antoniolosada/SLOT/docs/Componentes/atmega328-arduino-pinout.jpg

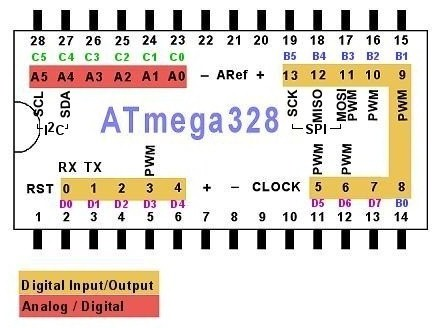
docs/Componentes/atmega328-arduino-pinout.jpg
