antoniolosada/SLOT/docs/NanoAnalogPinChanges.resized.jpg

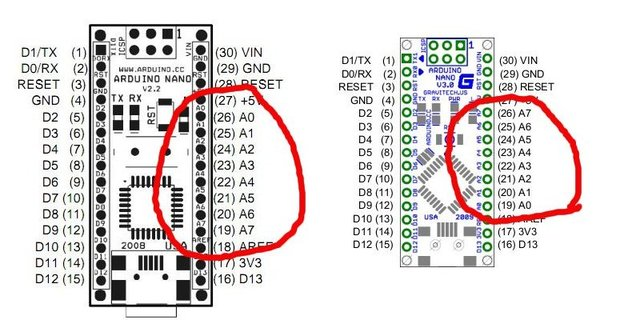
docs/NanoAnalogPinChanges.resized.jpg
