antoniolosada/SLOT/ArduinoProgramacion/usbasp-windriver.2011-05-28/Readme.txt

With WinAVR version 20100110 or older, please use libusb_0.1.12.1.
