antoniolosada/SLOT/docs/Fotos/IMG_2041.JPG

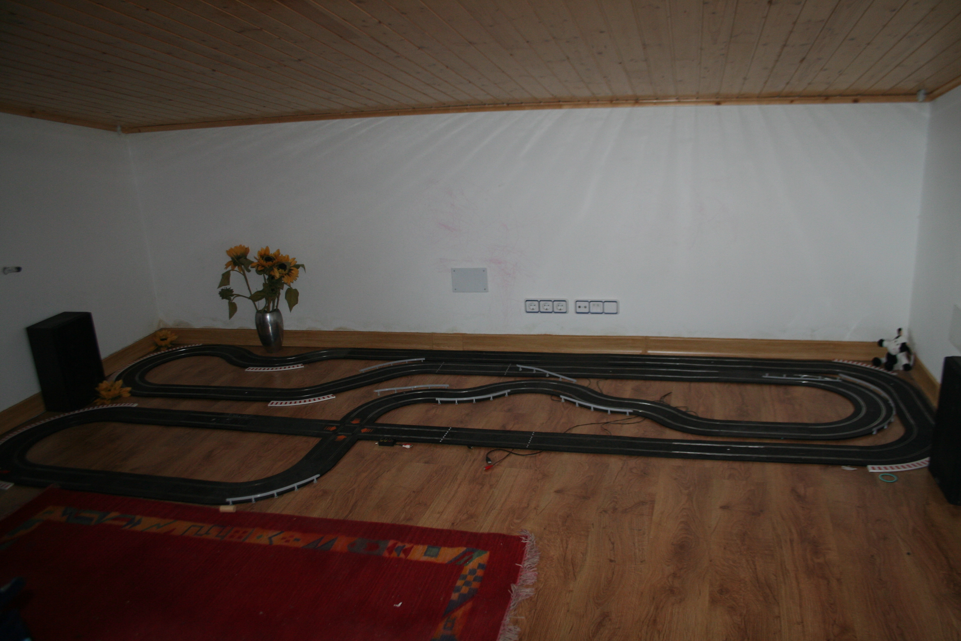
docs/Fotos/IMG_2041.JPG
