antoniolosada/SLOT/docs/Fotos/IMG_2042.JPG

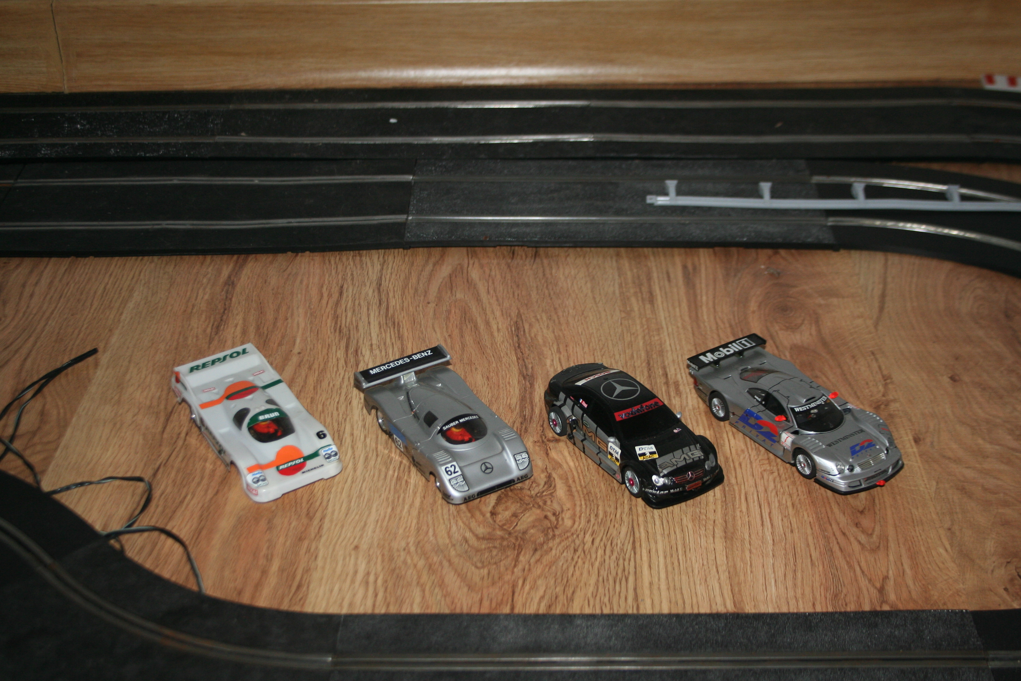
docs/Fotos/IMG_2042.JPG
