antoniolosada/SLOT/docs/Fotos/IMG_2043.JPG

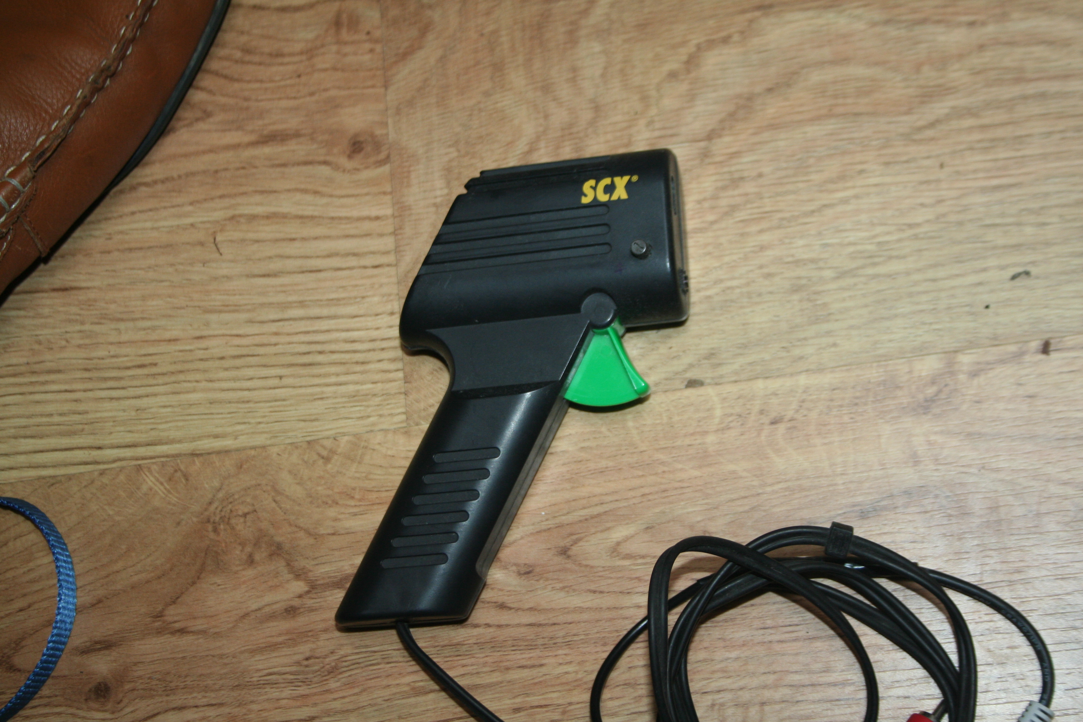
docs/Fotos/IMG_2043.JPG
