antoniolosada/SLOT/docs/Fotos/IMG_2044.JPG

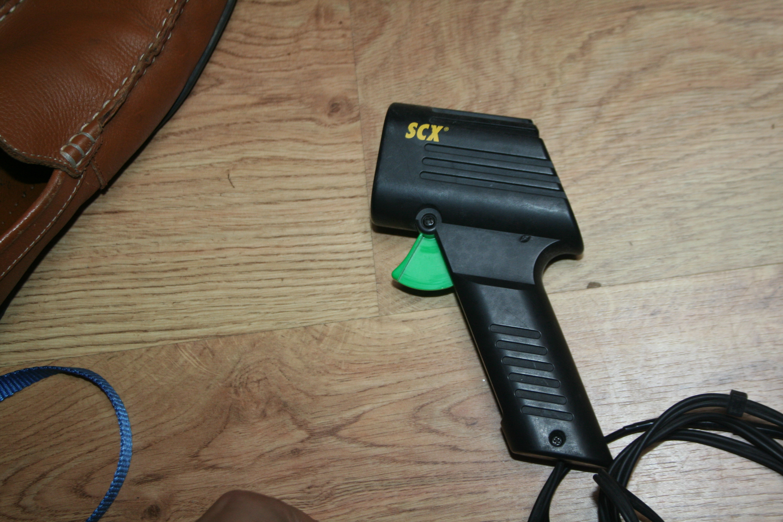
docs/Fotos/IMG_2044.JPG
