antoniolosada/SLOT/docs/Fotos/IMG_2045.JPG

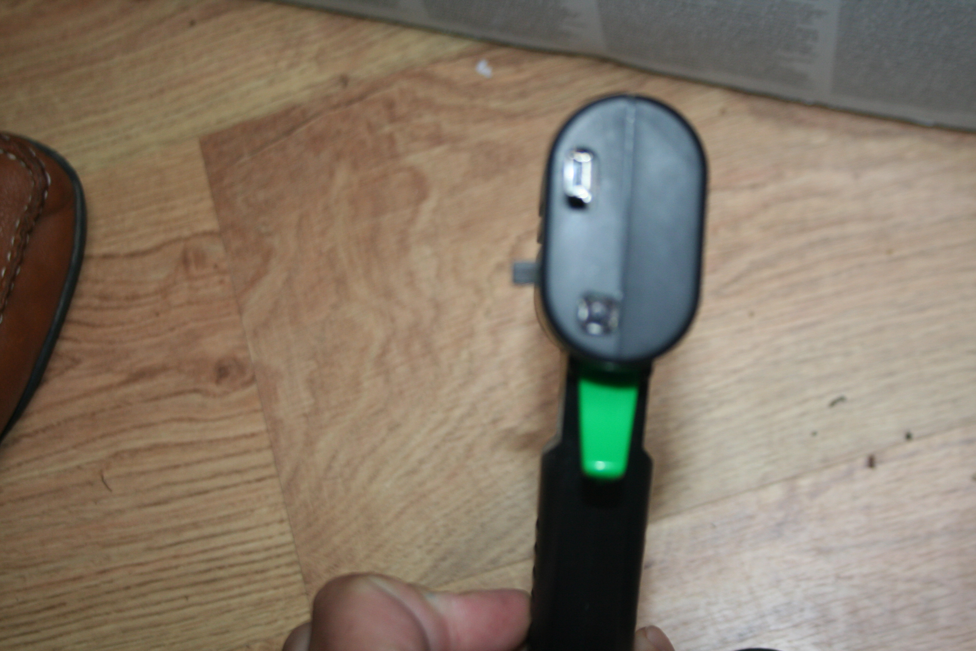
docs/Fotos/IMG_2045.JPG
