antoniolosada/SLOT/docs/Fotos/IMG_2046.JPG

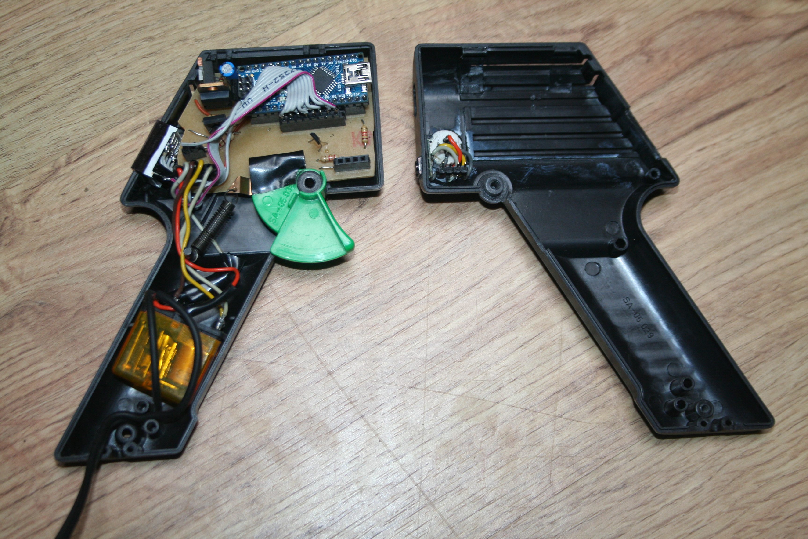
docs/Fotos/IMG_2046.JPG
