antoniolosada/SLOT/docs/Fotos/IMG_2047.JPG

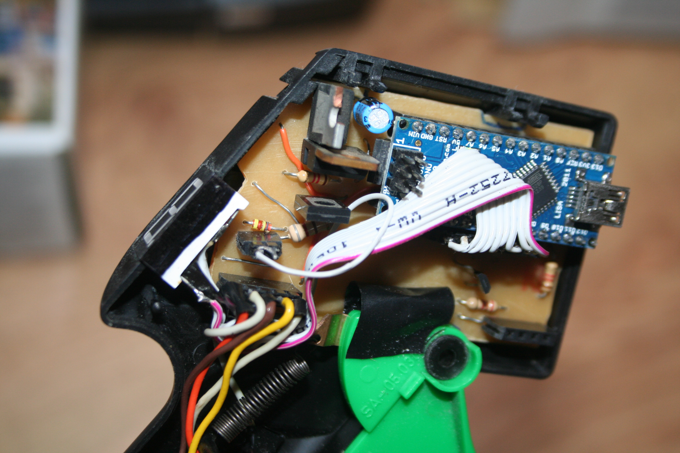
docs/Fotos/IMG_2047.JPG
