antoniolosada/SLOT/docs/Fotos/IMG_2049.JPG

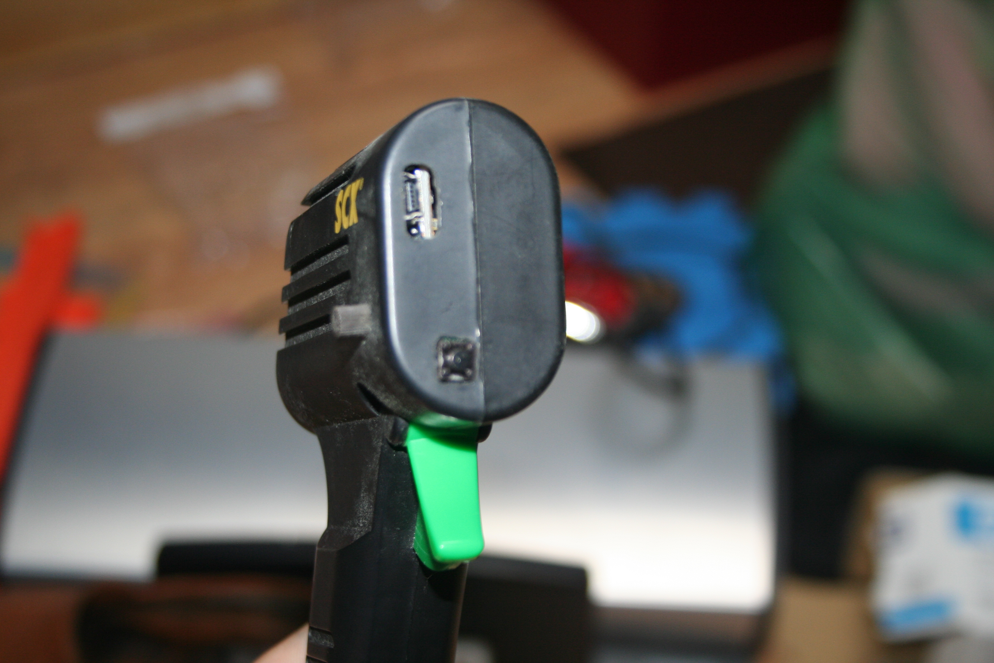
docs/Fotos/IMG_2049.JPG
