antoniolosada/SLOT/docs/Fotos/IMG_2050.JPG

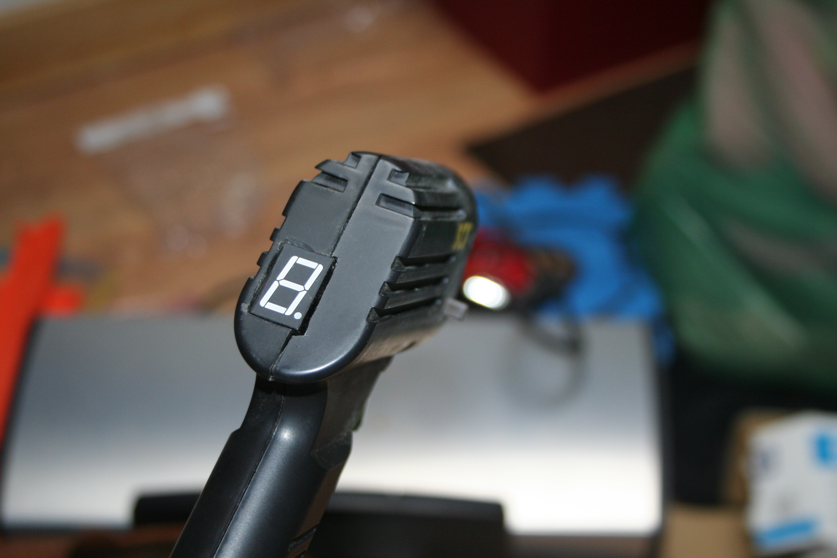
docs/Fotos/IMG_2050.JPG
