antoniolosada/SLOT/docs/Fotos/IMG_2051.JPG

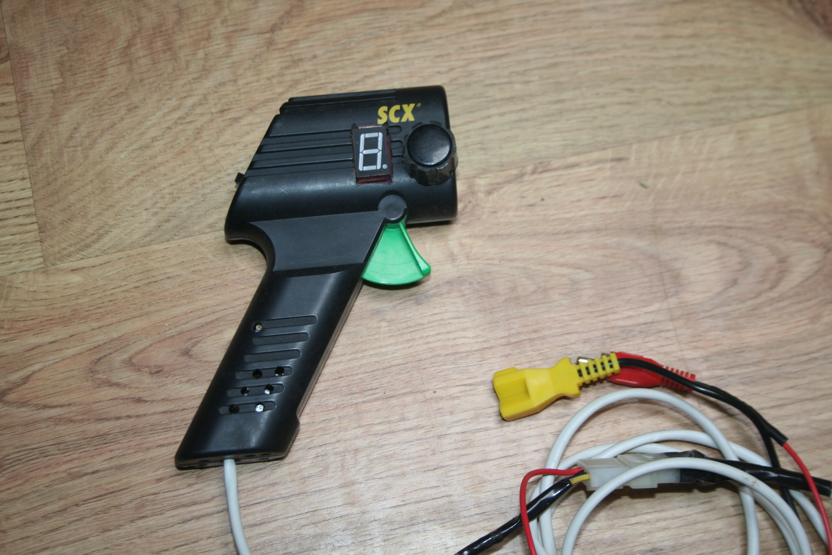
docs/Fotos/IMG_2051.JPG
