antoniolosada/SLOT/docs/Fotos/IMG_2052.JPG

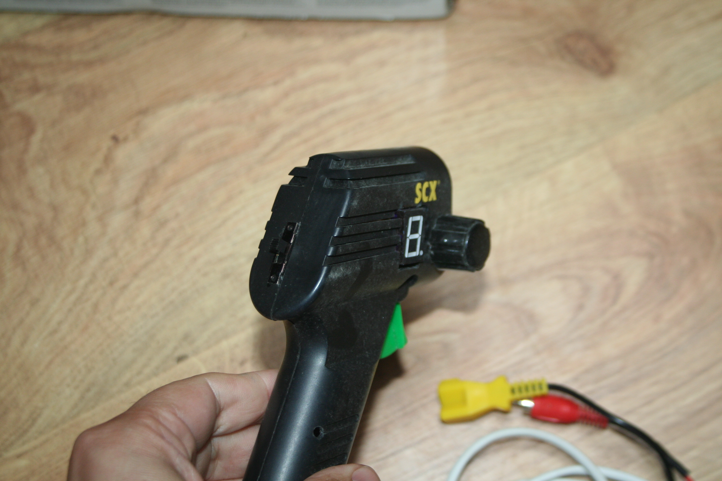
docs/Fotos/IMG_2052.JPG
