antoniolosada/SLOT/docs/Fotos/IMG_2053.JPG

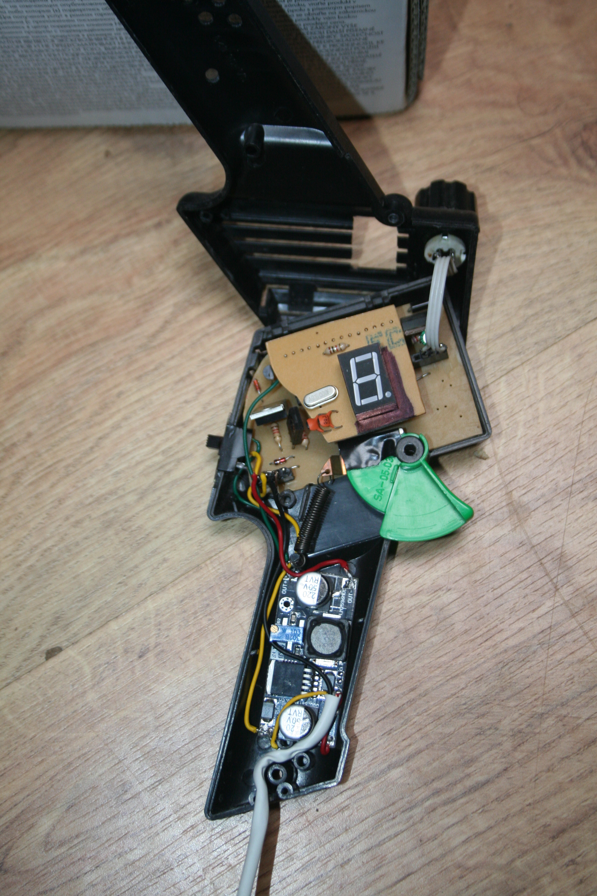
docs/Fotos/IMG_2053.JPG
