antoniolosada/SLOT/docs/Fotos/IMG_2054.JPG

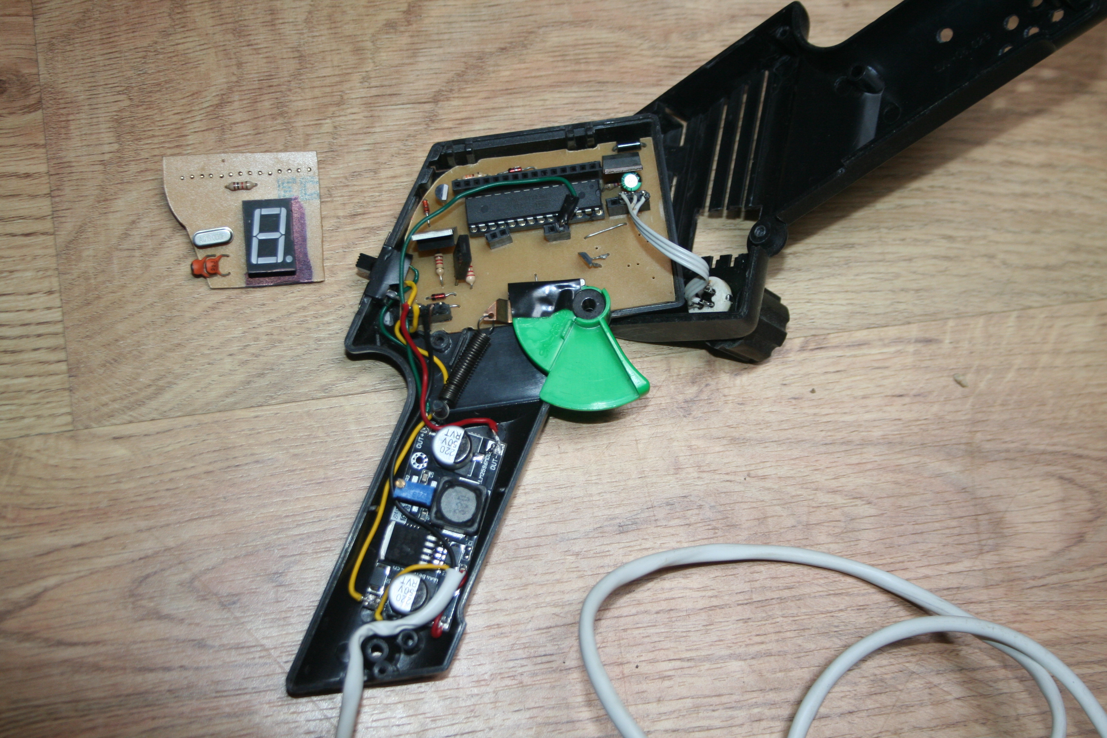
docs/Fotos/IMG_2054.JPG
