antoniolosada/SLOT/docs/Fotos/la foto 1.JPG

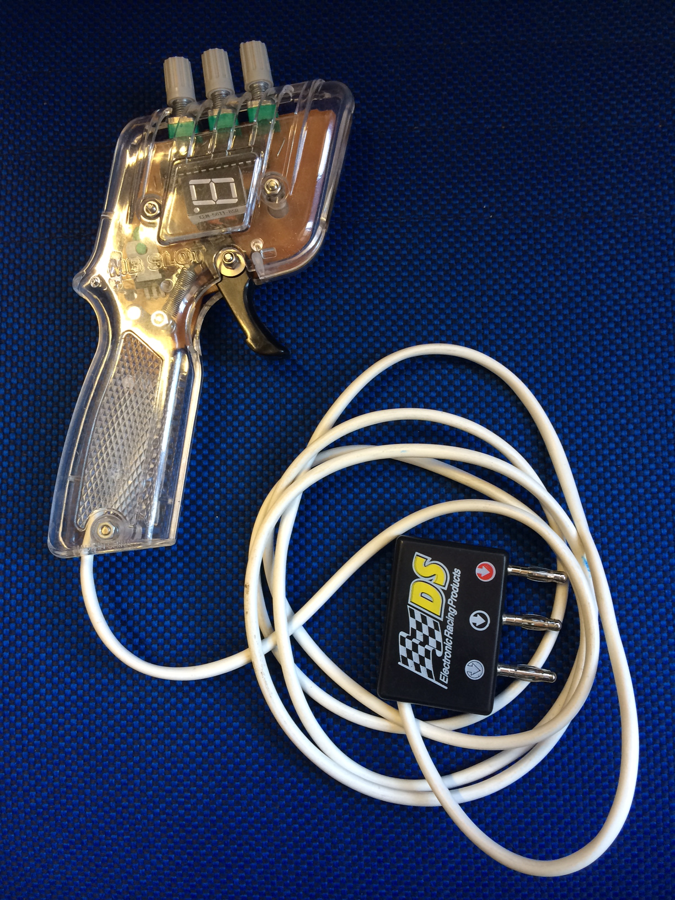
docs/Fotos/la foto 1.JPG
