antoniolosada/SLOT/docs/Fotos/la foto 2.JPG

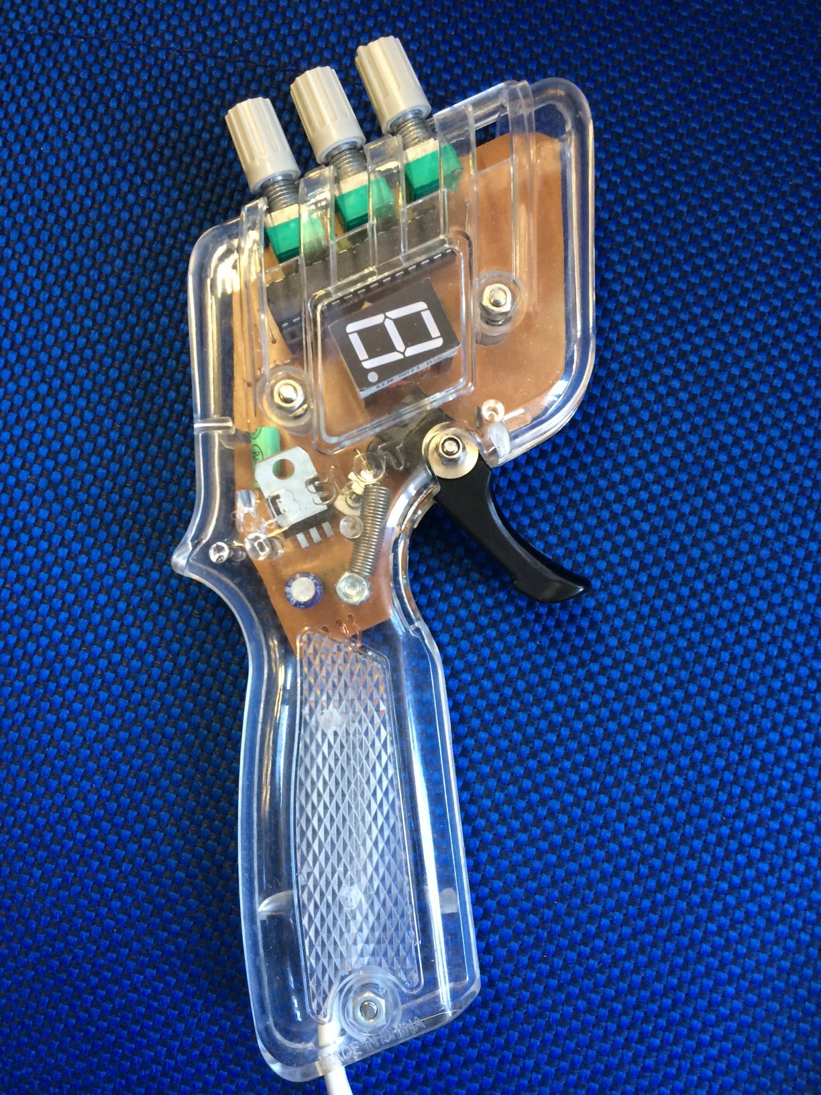
docs/Fotos/la foto 2.JPG
