antoniolosada/SLOT/docs/Fotos/la foto 3.JPG

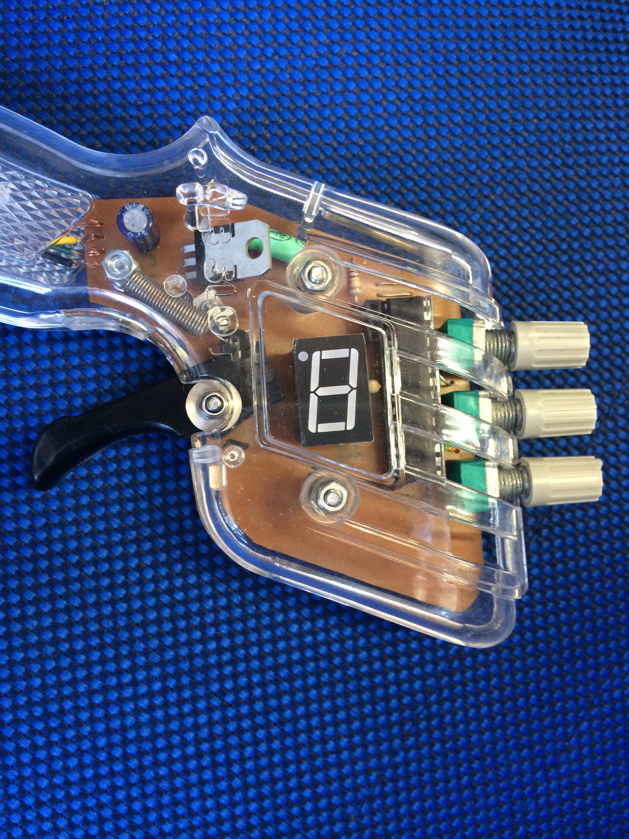
docs/Fotos/la foto 3.JPG
