antoniolosada/SLOT/docs/Fotos/la foto 4.JPG

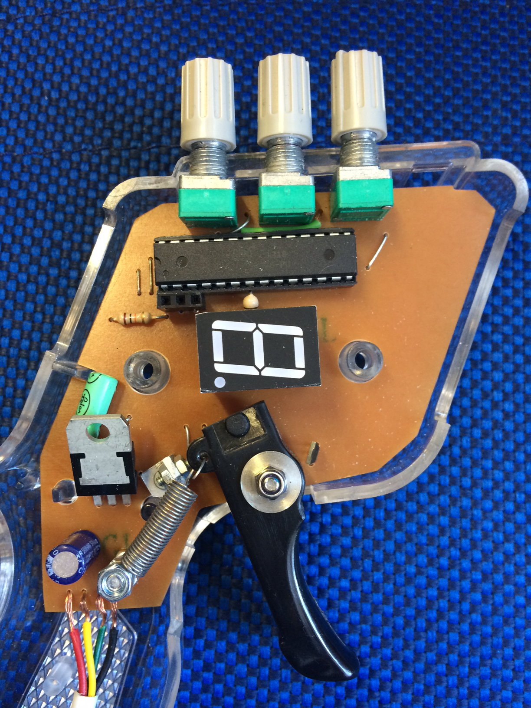
docs/Fotos/la foto 4.JPG
