antoniolosada/SLOT/docs/Fotos/la foto 5.JPG

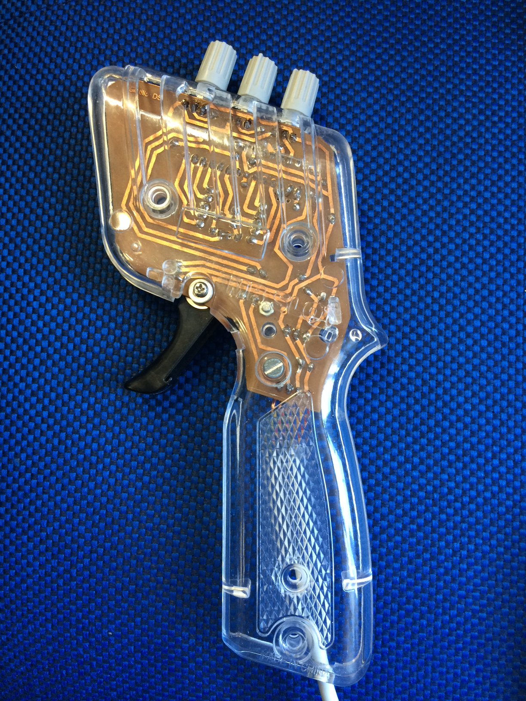
docs/Fotos/la foto 5.JPG
