antoniolosada/SLOT/docs/Fotos/PICT0441.JPG

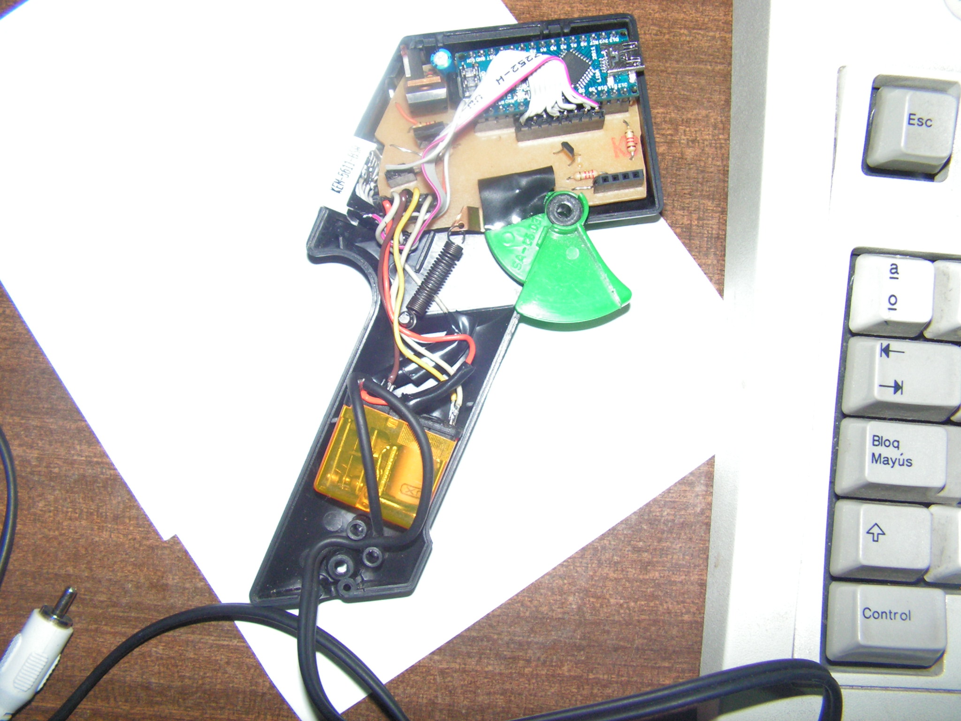
docs/Fotos/PICT0441.JPG
