antoniolosada/SLOT/docs/Fotos/PICT0442.JPG

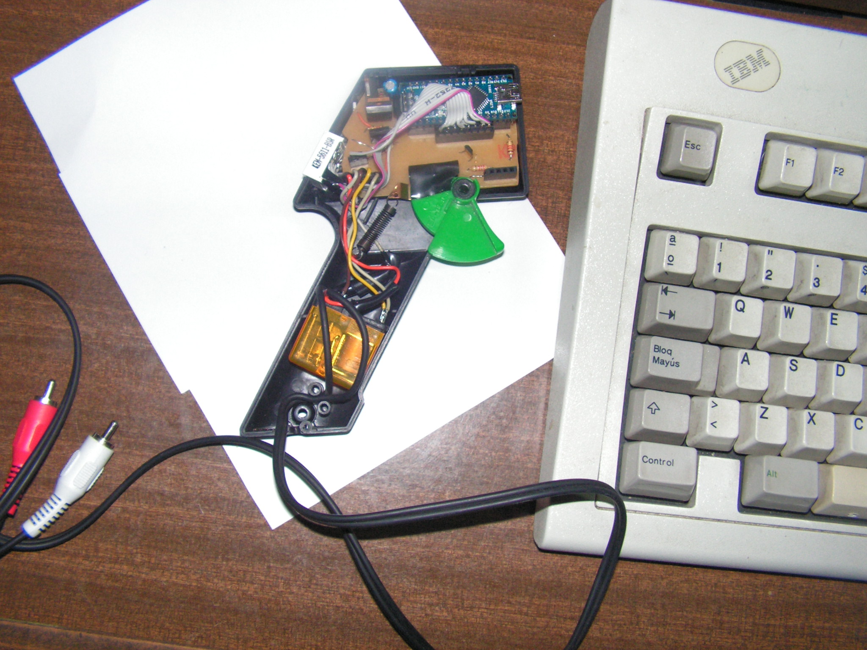
docs/Fotos/PICT0442.JPG
