antoniolosada/SLOT/docs/hermes.gif

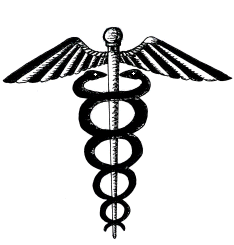
docs/hermes.gif
