antoniolosada/SLOT/docs/nano_4.jpg

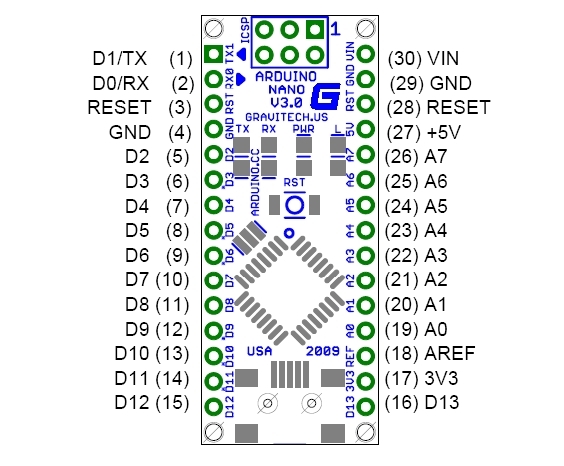
docs/nano_4.jpg
