antoniolosada/SLOT/docs/Oscilo/FEM negativa pasada por transistor PNP.gif

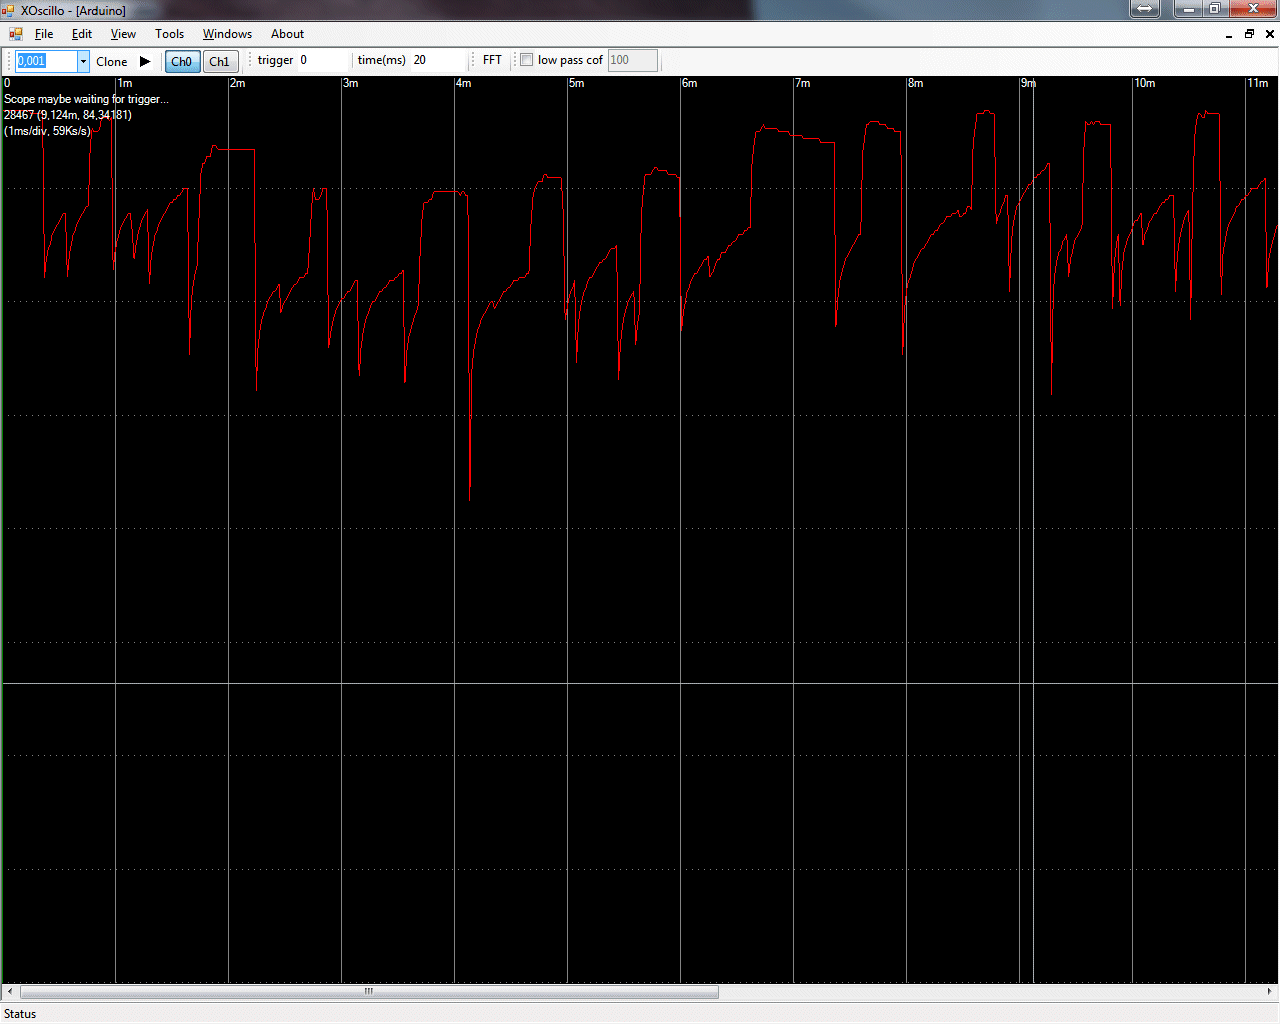
docs/Oscilo/FEM negativa pasada por transistor PNP.gif
