antoniolosada/SLOT/docs/Oscilo/Gas alto con coche en el aire.gif

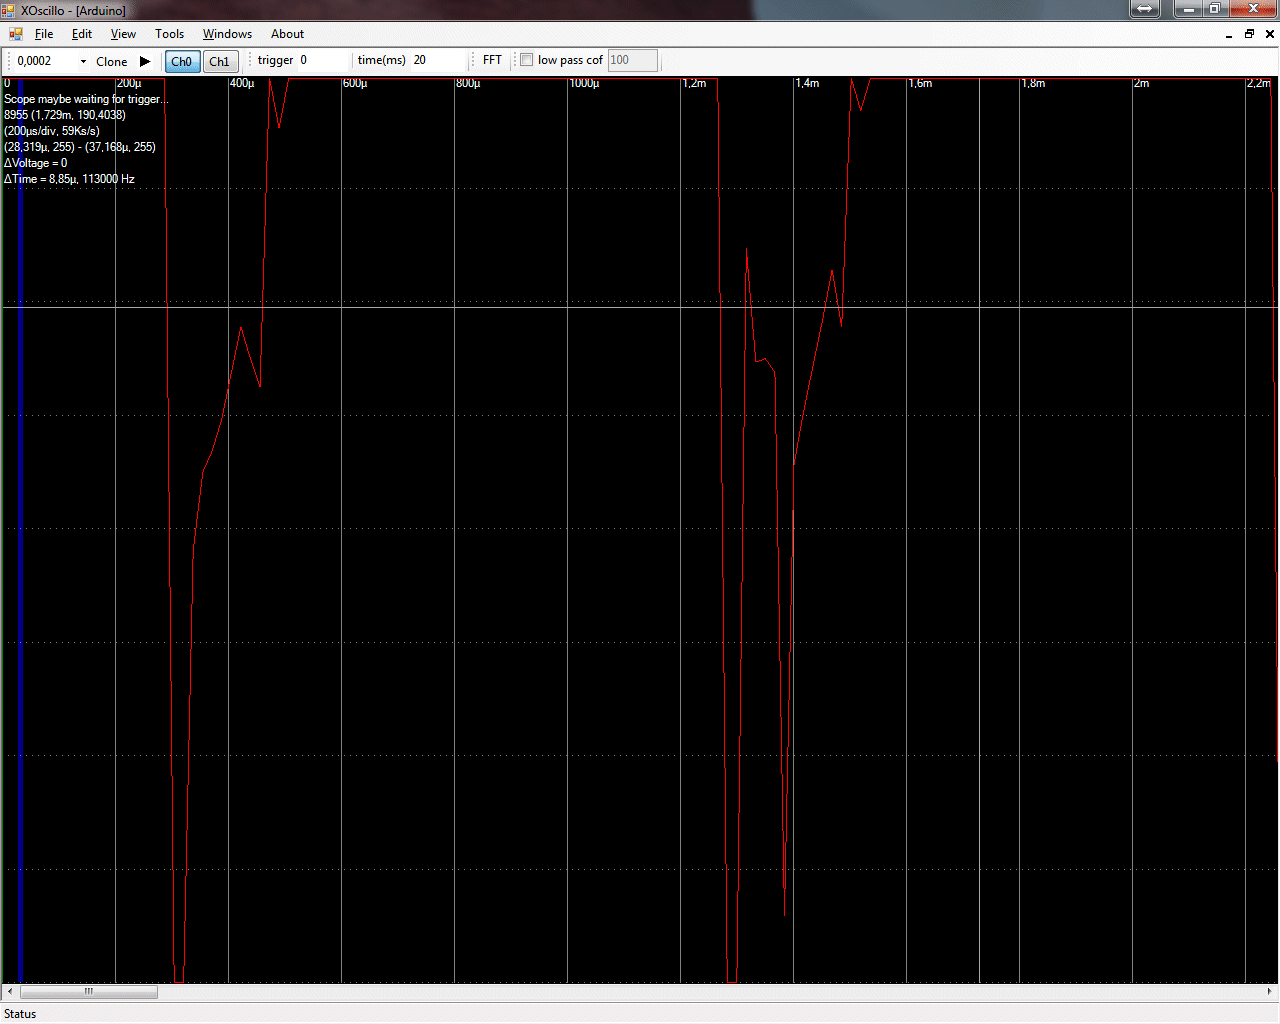
docs/Oscilo/Gas alto con coche en el aire.gif
