antoniolosada/SLOT/docs/Oscilo/Gas Alto forzando reducción de vueltas.gif

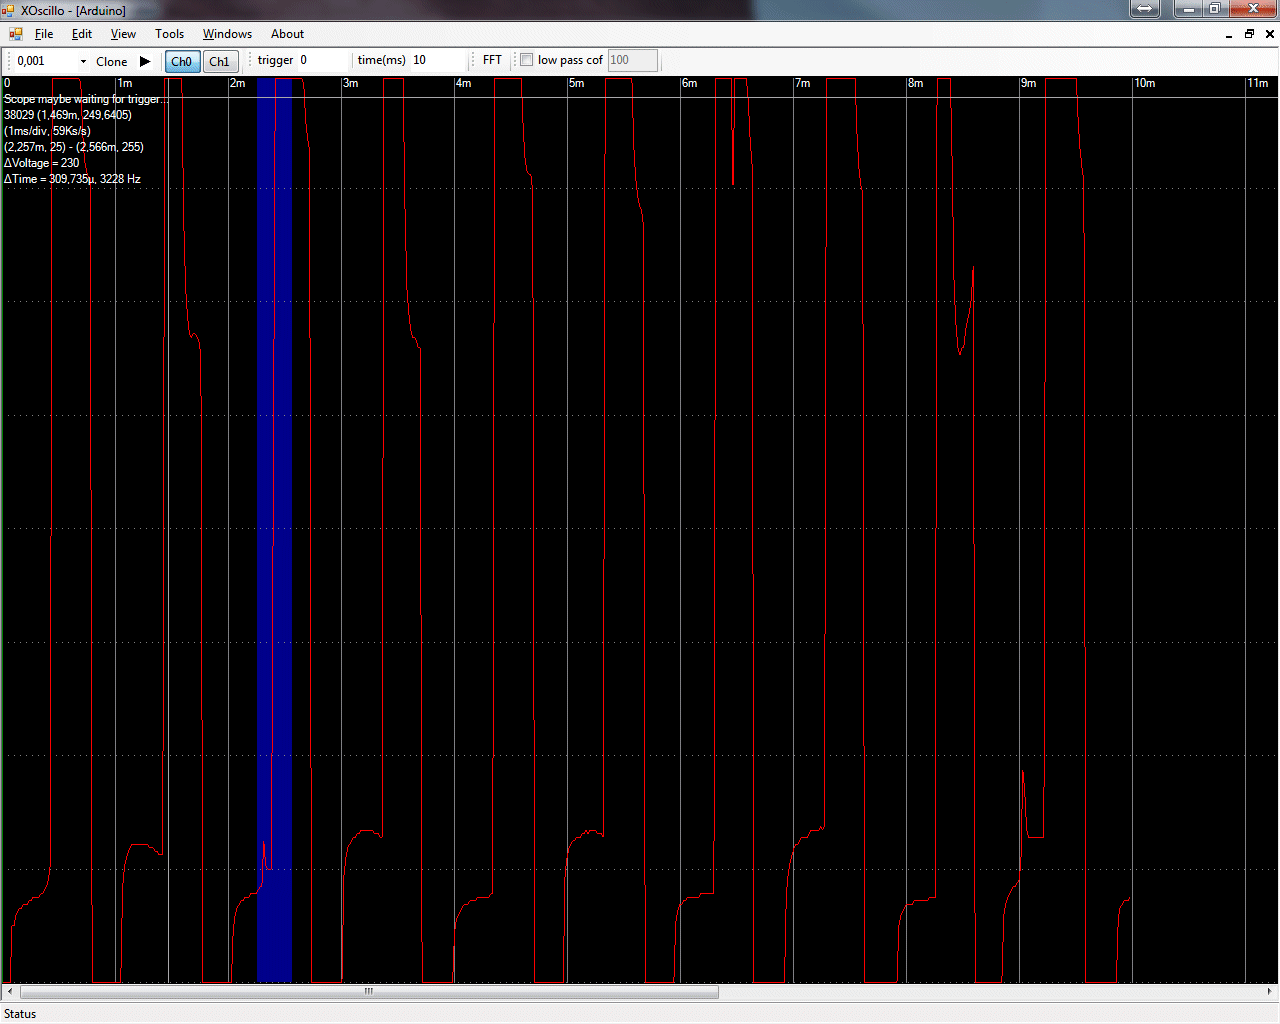
docs/Oscilo/Gas Alto forzando reducción de vueltas.gif
