antoniolosada/SLOT/docs/Oscilo/Gas bajo antes del arranque.gif

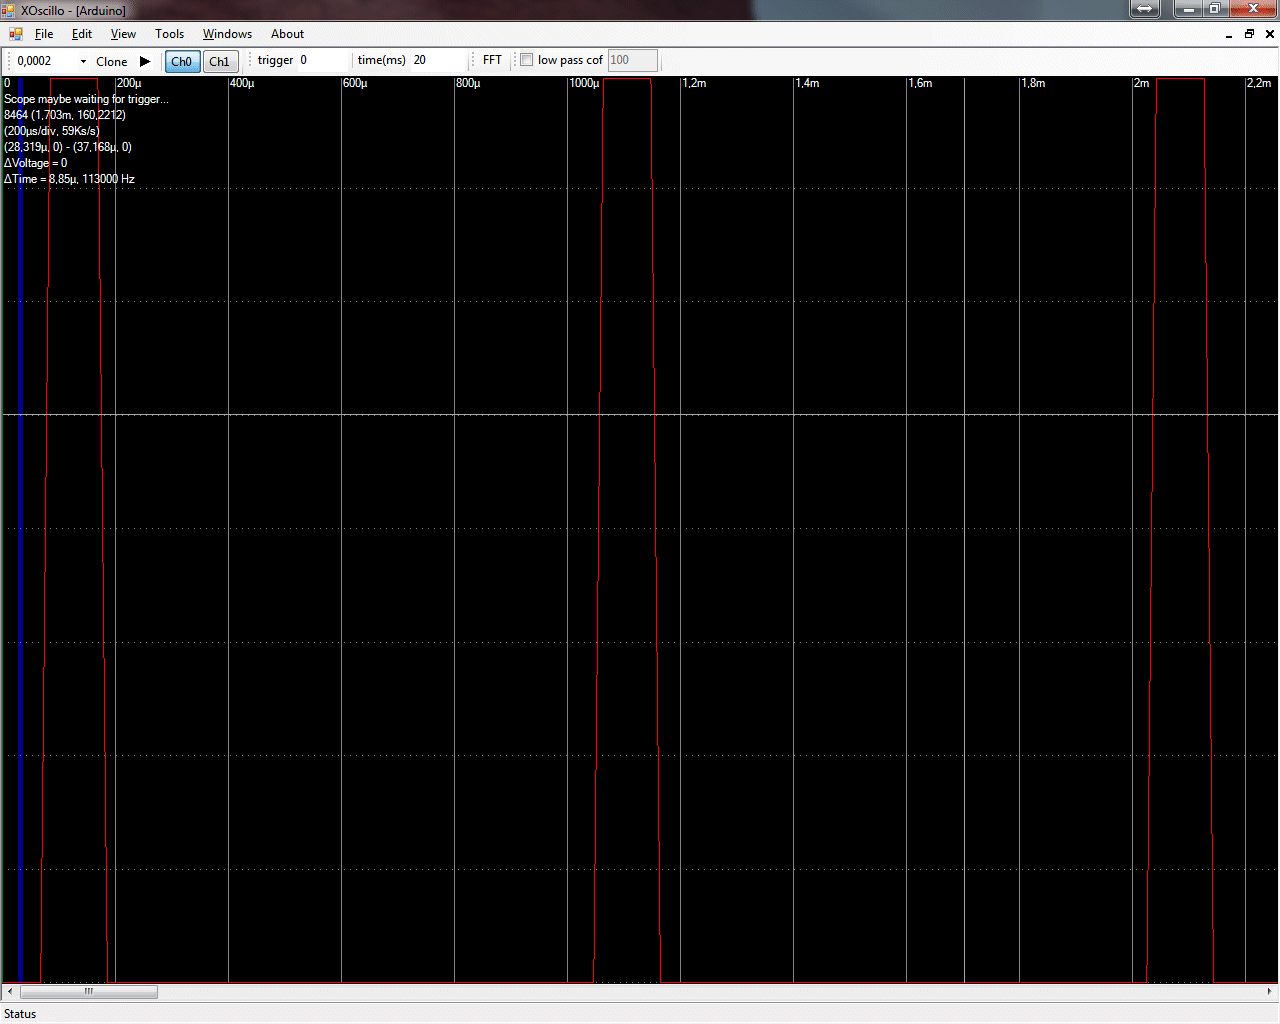
docs/Oscilo/Gas bajo antes del arranque.gif
