antoniolosada/SLOT/docs/Oscilo/Gas bajo con motor en marcha a bajas vueltas.gif

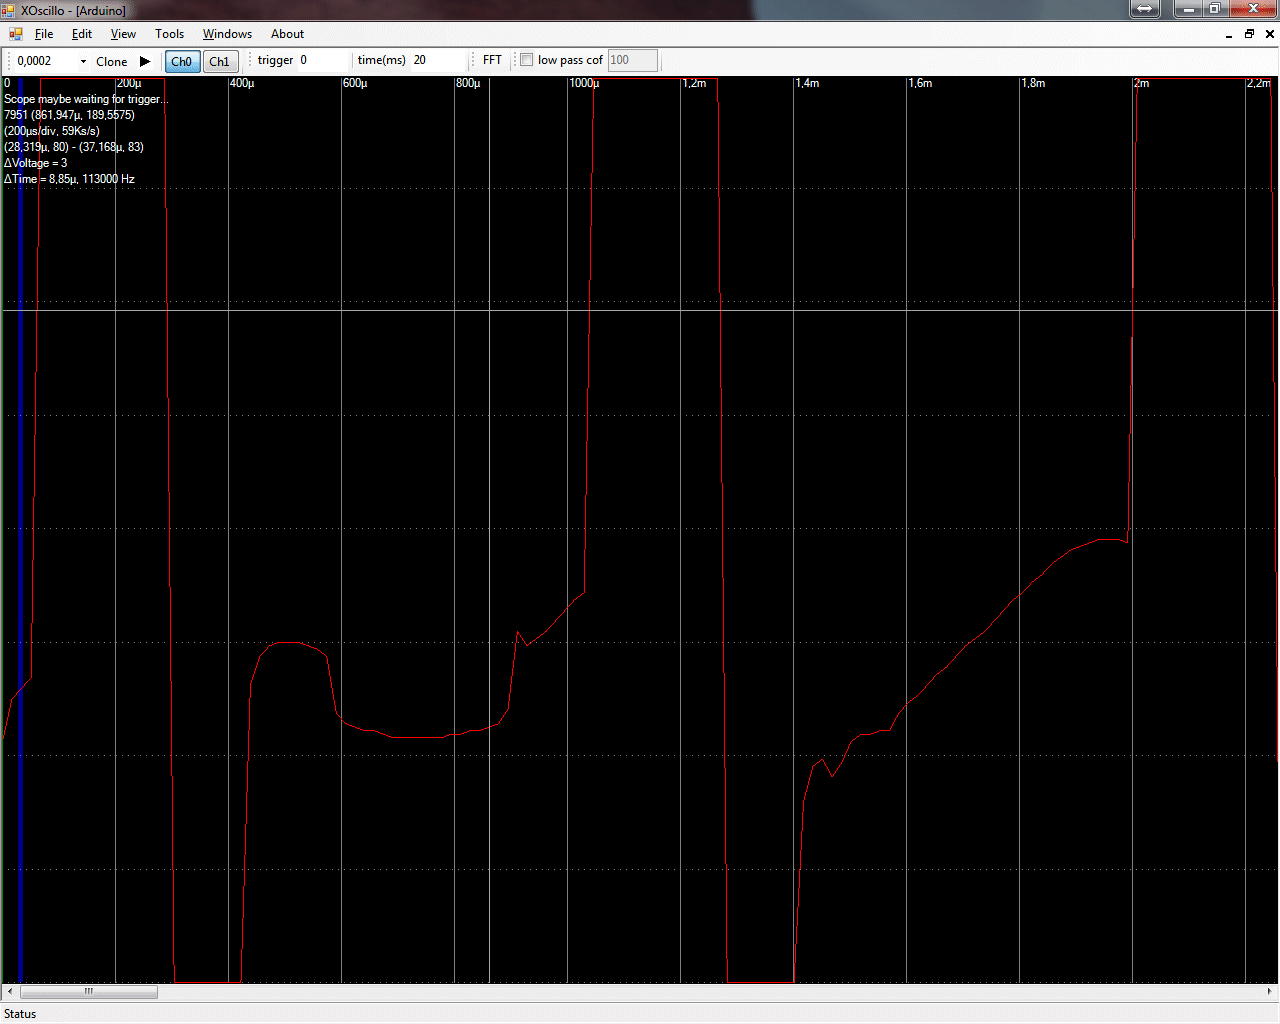
docs/Oscilo/Gas bajo con motor en marcha a bajas vueltas.gif
