antoniolosada/SLOT/docs/Oscilo/Gas casi al máximo sin coche en pista.gif

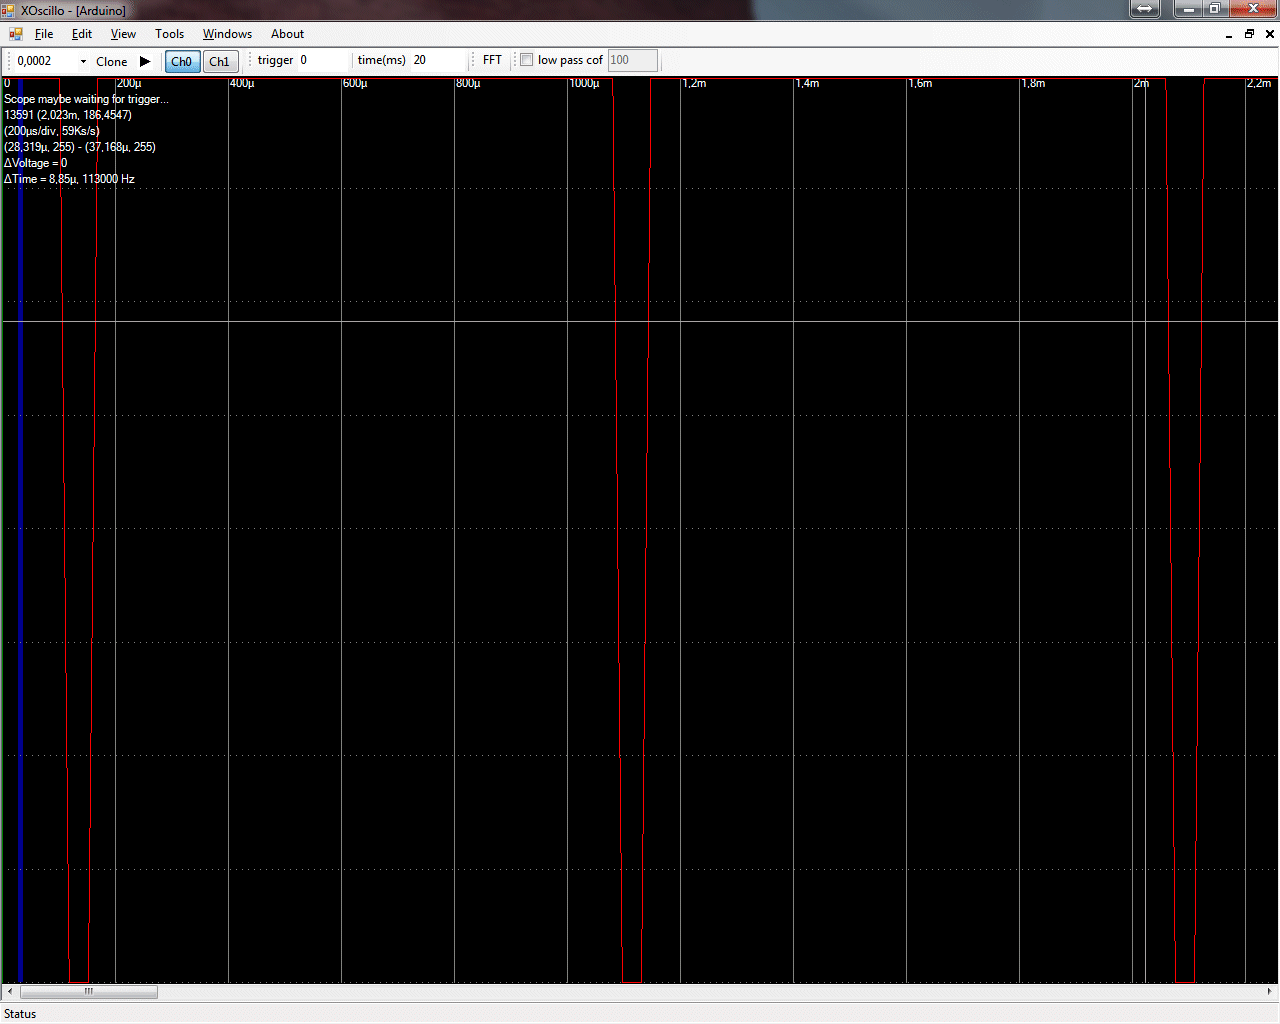
docs/Oscilo/Gas casi al máximo sin coche en pista.gif
