antoniolosada/SLOT/docs/Oscilo/Tope de gas con modificación para evitar pulsos a máximo gas.gif

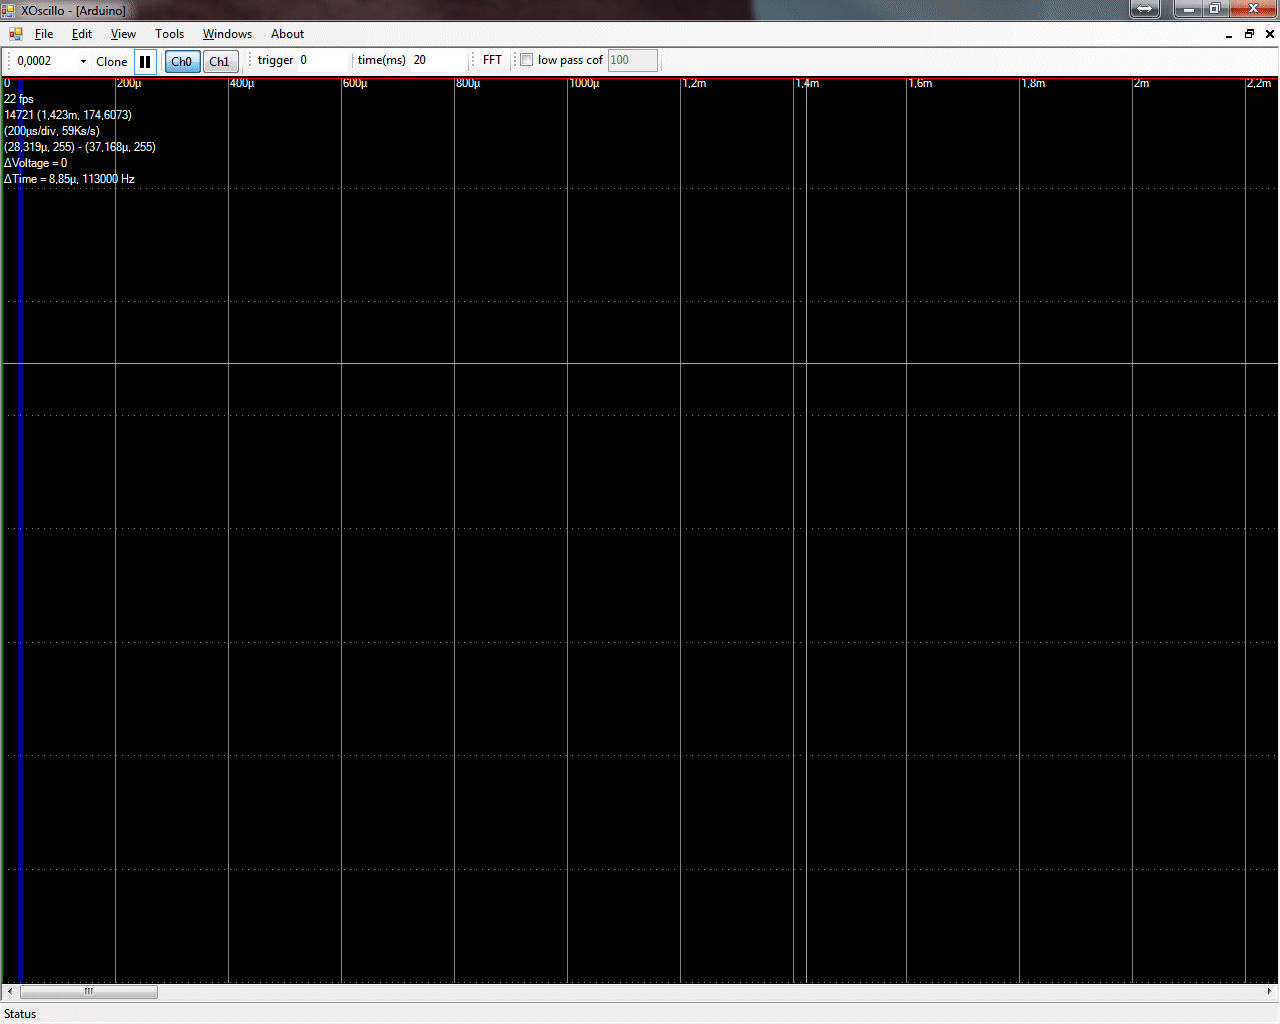
docs/Oscilo/Tope de gas con modificación para evitar pulsos a máximo gas.gif
