antoniolosada/SLOT/docs/Regulador/ip350t.png

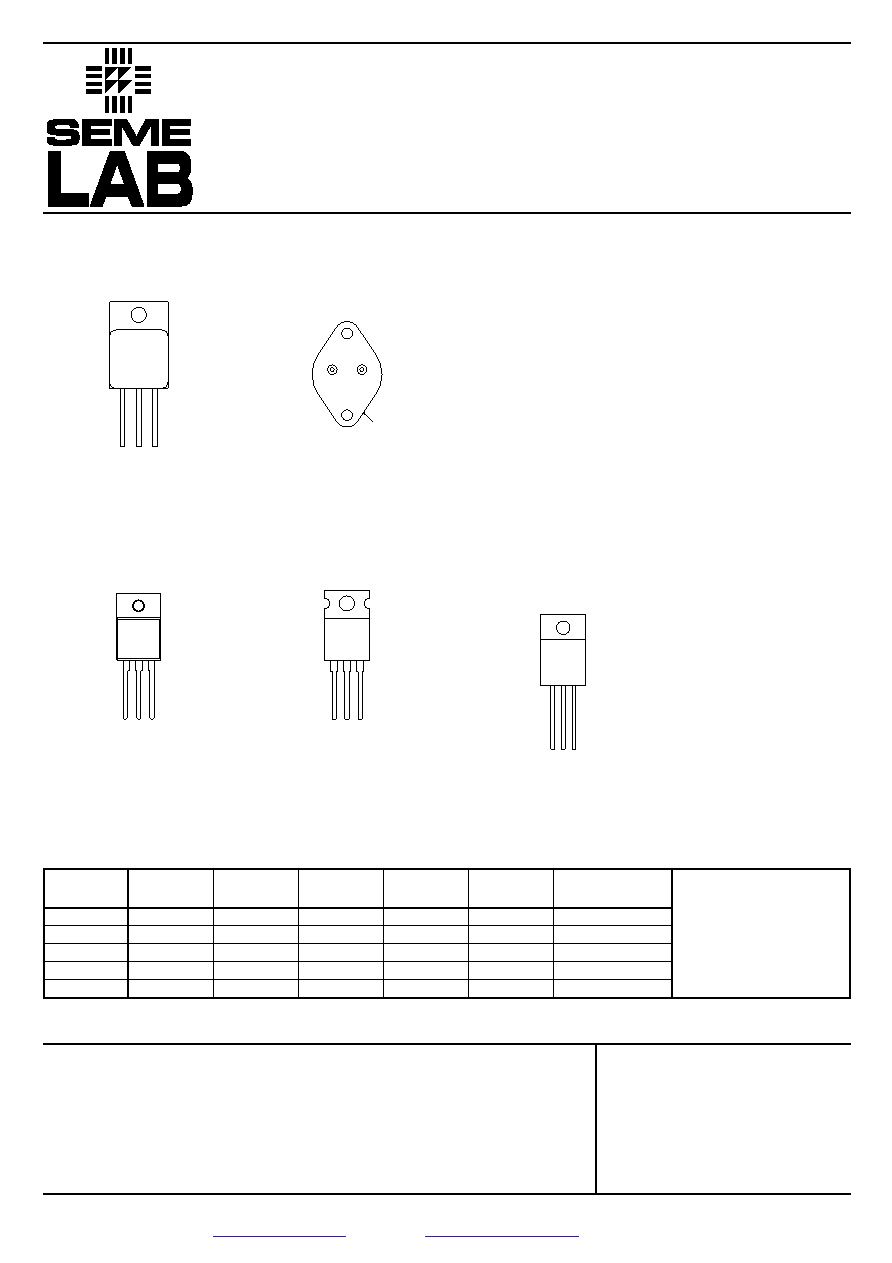
docs/Regulador/ip350t.png
