antoniolosada/SLOT/docs/Transistores/2SC945-GR.png

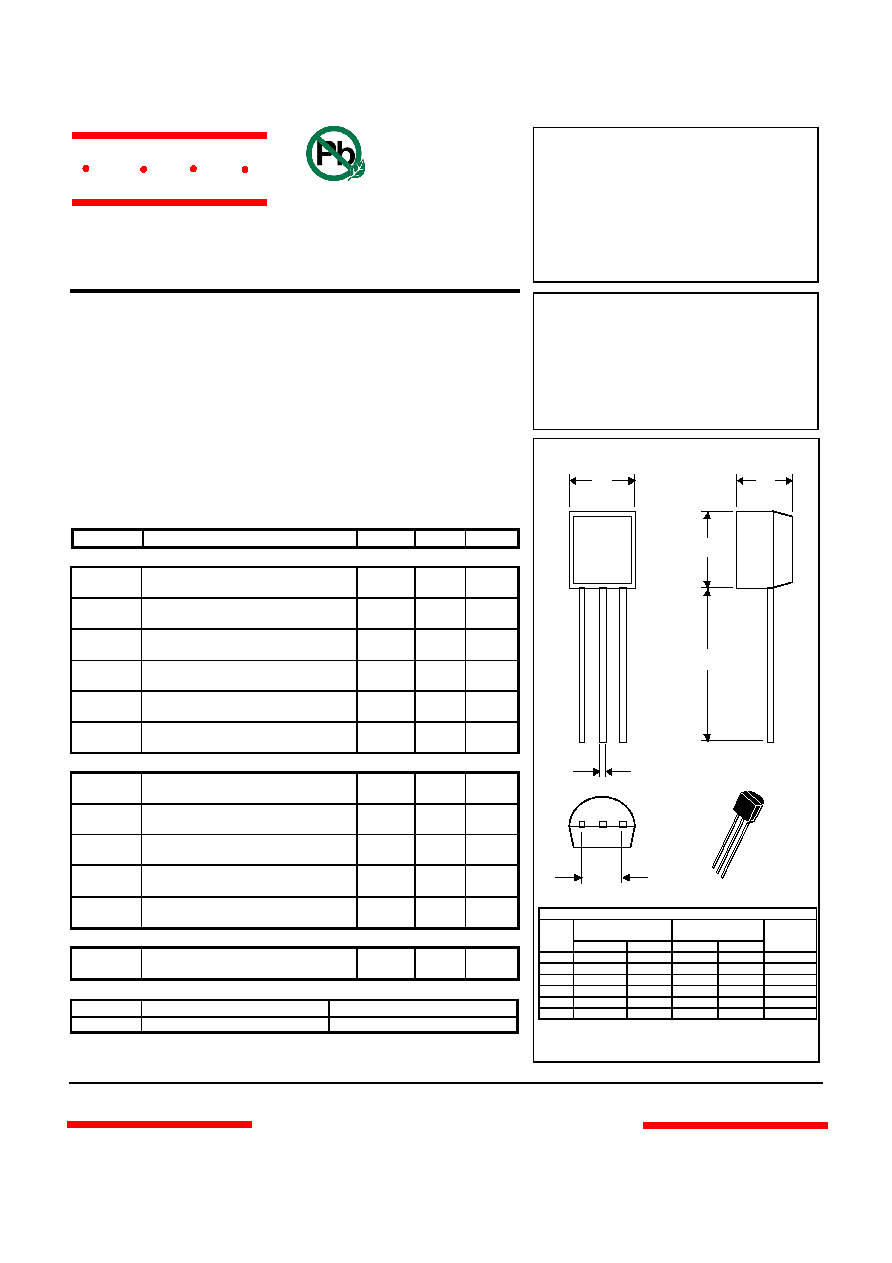
docs/Transistores/2SC945-GR.png
