antoniolosada/SLOT/docs/Transistores/mc140_tr_muestra2.gif

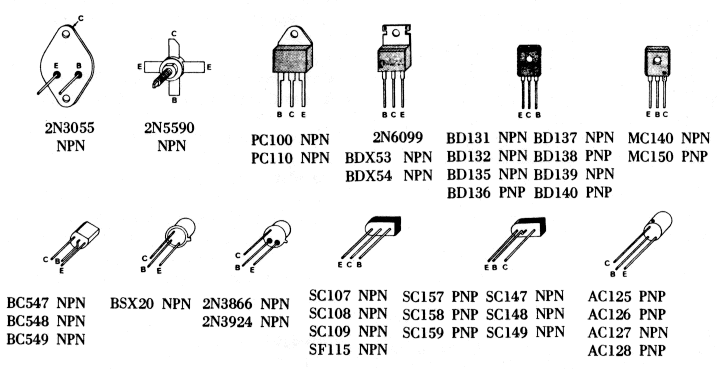
docs/Transistores/mc140_tr_muestra2.gif
