antoniolosada/SLOT/docs/Transistores/mosfet p/descarga.jpg

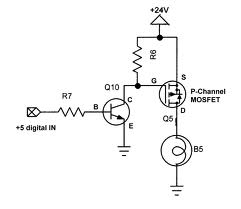
docs/Transistores/mosfet p/descarga.jpg
