antoniolosada/SLOT/docs/Transistores/mosfet p/httpimg208.imageshack.usimg2087883highsideswitchau5.png

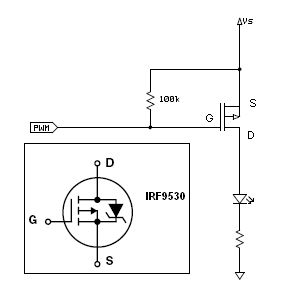
docs/Transistores/mosfet p/httpimg208.imageshack.usimg2087883highsideswitchau5.png
