antoniolosada/SLOT/docs/Transistores/mosfet p/n channel images.jpg

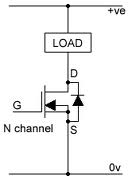
docs/Transistores/mosfet p/n channel images.jpg
