antoniolosada/SLOT/docs/Transistores/transistor-tip42c.jpg

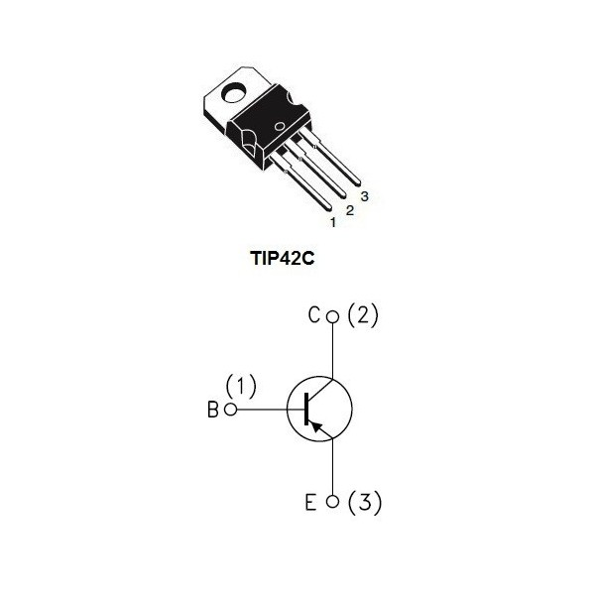
docs/Transistores/transistor-tip42c.jpg
