antoniolosada/SLOT/graficos/0.gif

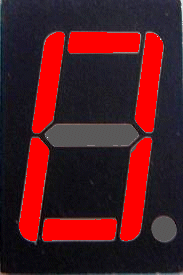
graficos/0.gif
