antoniolosada/SLOT/imagenes/atmega328_2pisos.gif

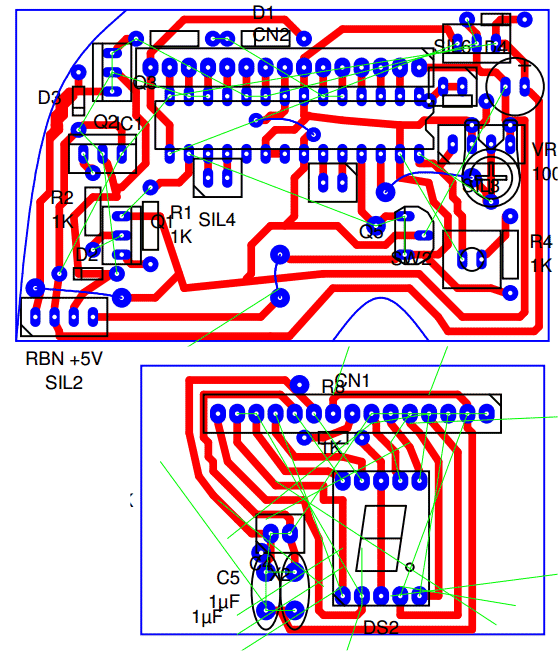
imagenes/atmega328_2pisos.gif
