antoniolosada/SLOT/imagenes/atmega328_2pisos_foto.gif

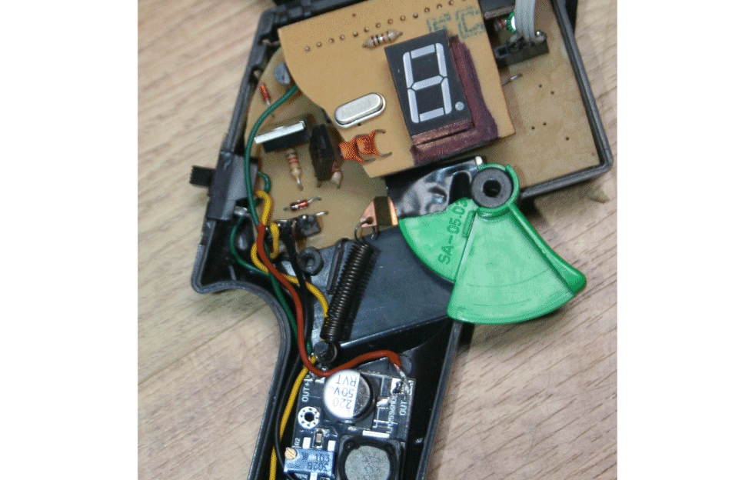
imagenes/atmega328_2pisos_foto.gif
