antoniolosada/SLOT/imagenes/esquema_atmega328_2pisos.gif

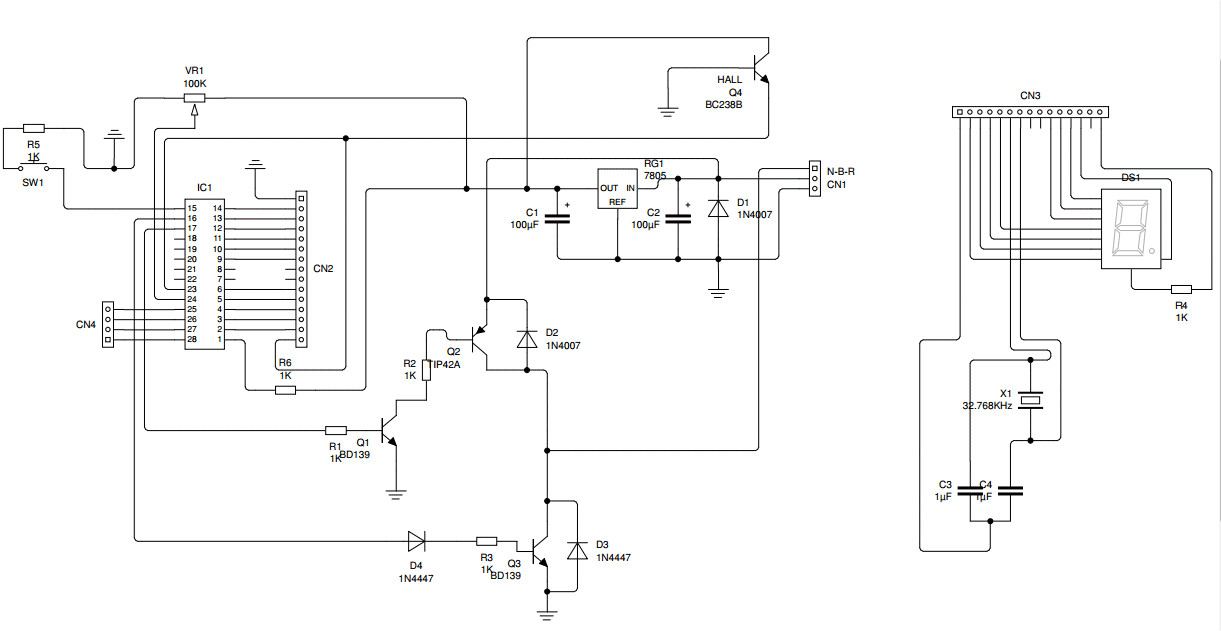
imagenes/esquema_atmega328_2pisos.gif
