antoniolosada/SLOT/imagenes/esquema_atmega328_piso2.gif

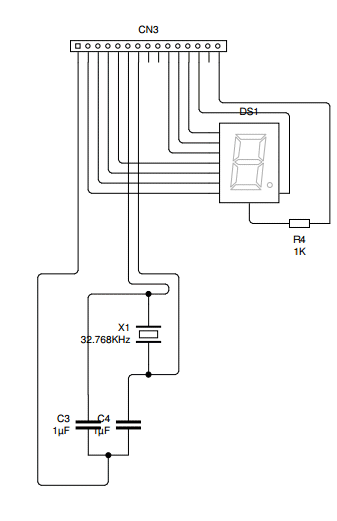
imagenes/esquema_atmega328_piso2.gif
