antoniolosada/SLOT/imagenes/hermes v1.3.gif

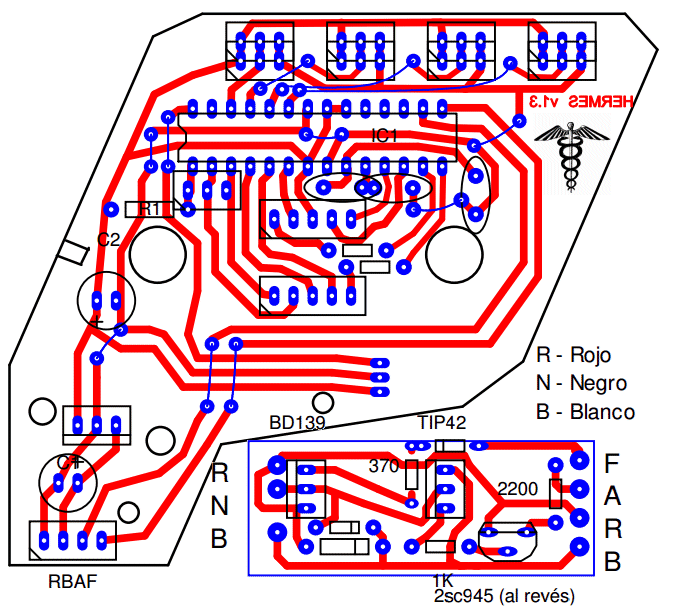
imagenes/hermes v1.3.gif
