antoniolosada/SLOT/imagenes/hermes v1.JPG

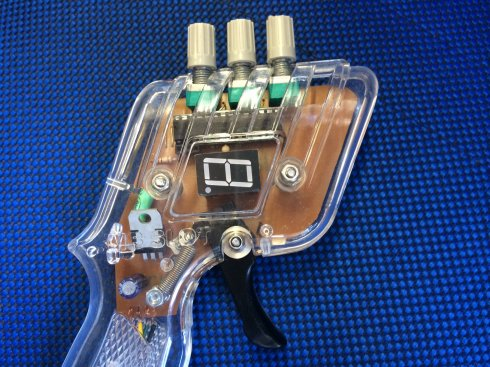
imagenes/hermes v1.JPG
