antoniolosada/SLOT/imagenes/HERMES v1_1digito.gif

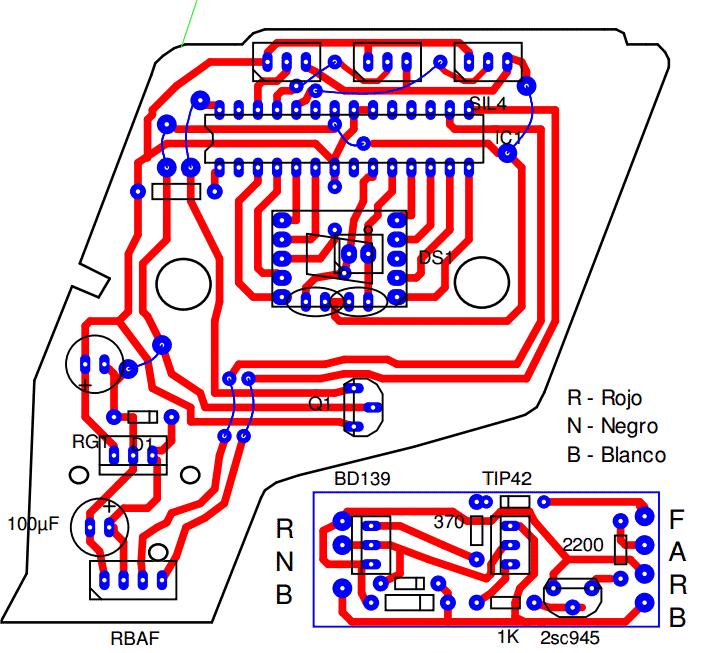
imagenes/HERMES v1_1digito.gif
