antoniolosada/SLOT/imagenes/HERMES_digital.gif

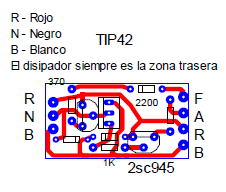
imagenes/HERMES_digital.gif
