antoniolosada/SLOT/imagenes/hermes_v1.gif

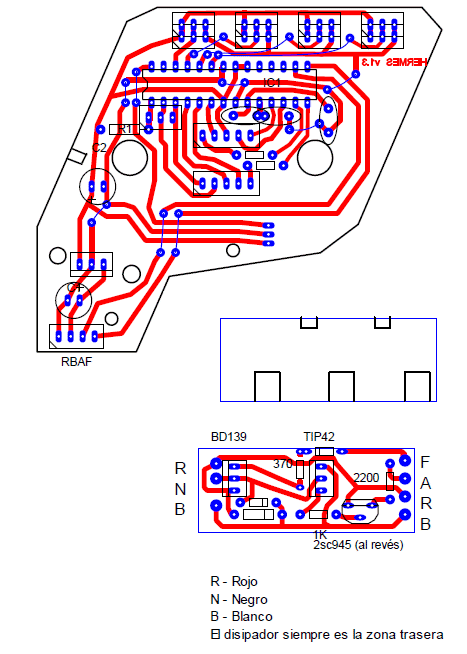
imagenes/hermes_v1.gif
