antoniolosada/SLOT/imagenes/HermesV1.JPG

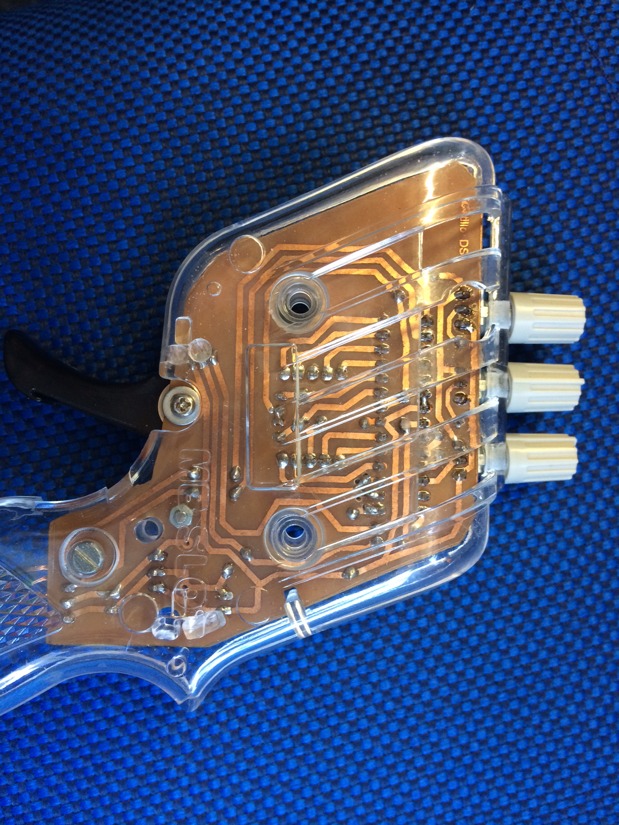
imagenes/HermesV1.JPG
