antoniolosada/SLOT/imagenes/HermesV1_2.JPG

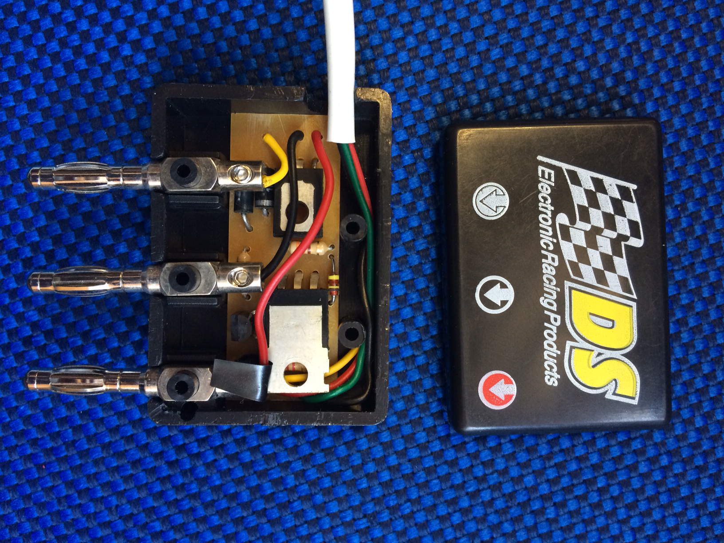
imagenes/HermesV1_2.JPG
