antoniolosada/SLOT/imagenes/HermesV1_4.JPG

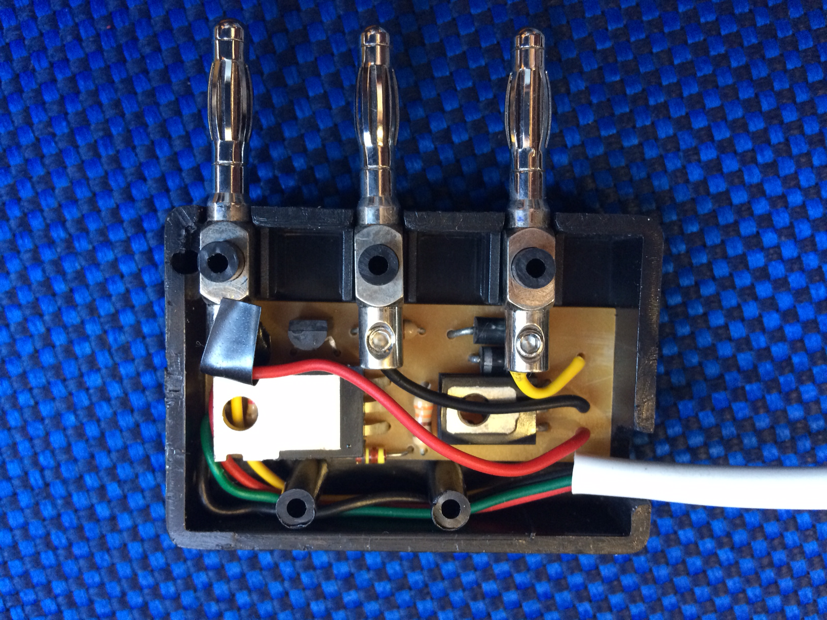
imagenes/HermesV1_4.JPG
