antoniolosada/SLOT/imagenes/HermesV1_6.JPG

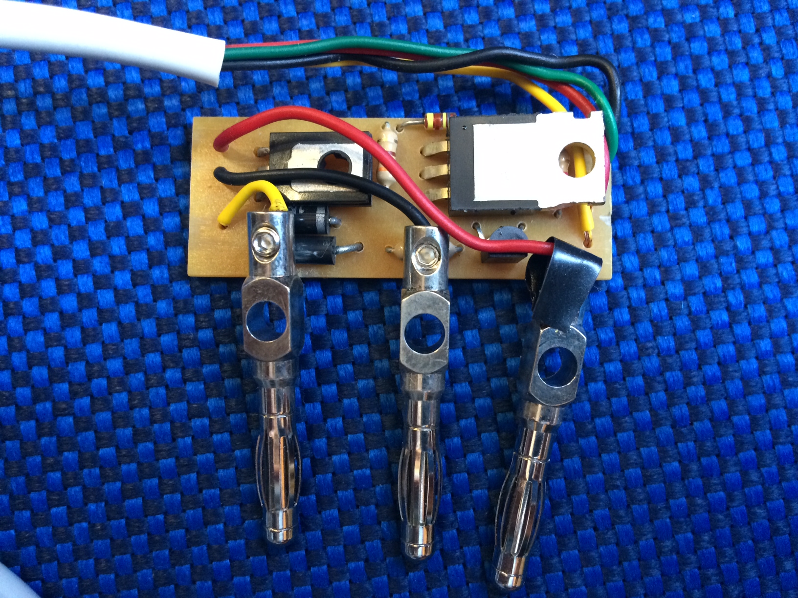
imagenes/HermesV1_6.JPG
