antoniolosada/SLOT/imagenes/HermesV1_8.JPG

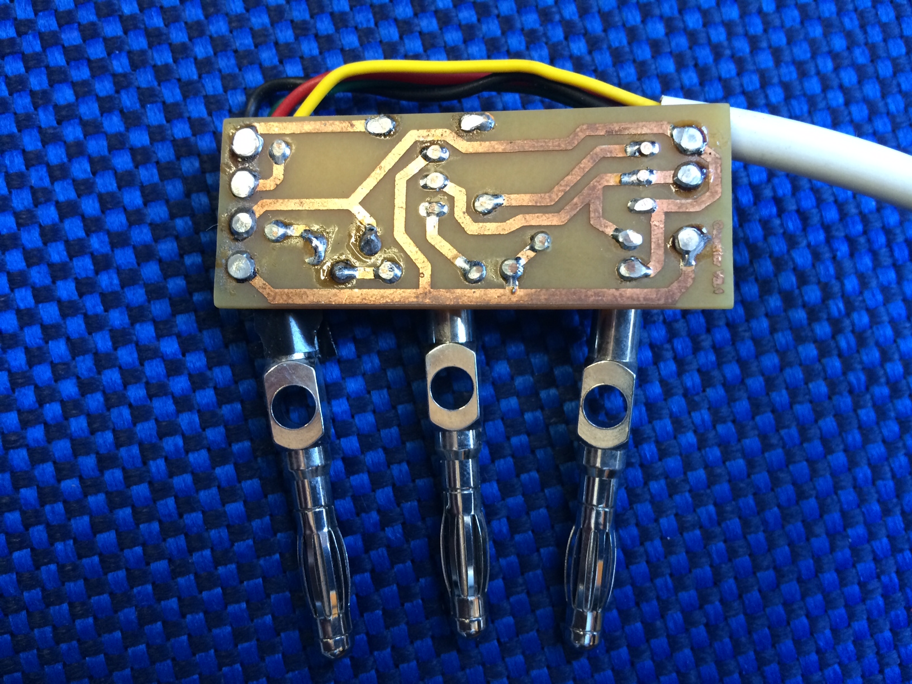
imagenes/HermesV1_8.JPG
