antoniolosada/SLOT/imagenes/nano_placa.gif

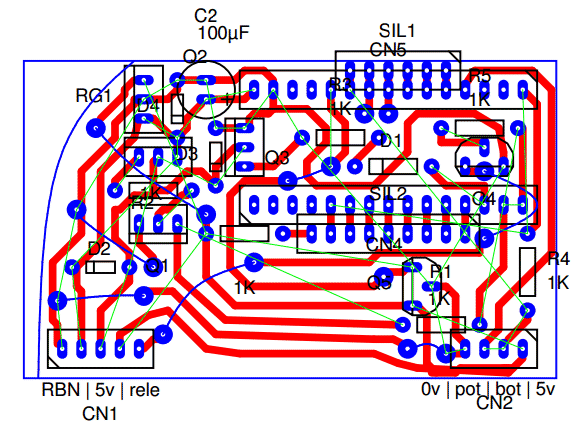
imagenes/nano_placa.gif
