antoniolosada/SLOT/imagenes/scx_nano_peque.gif

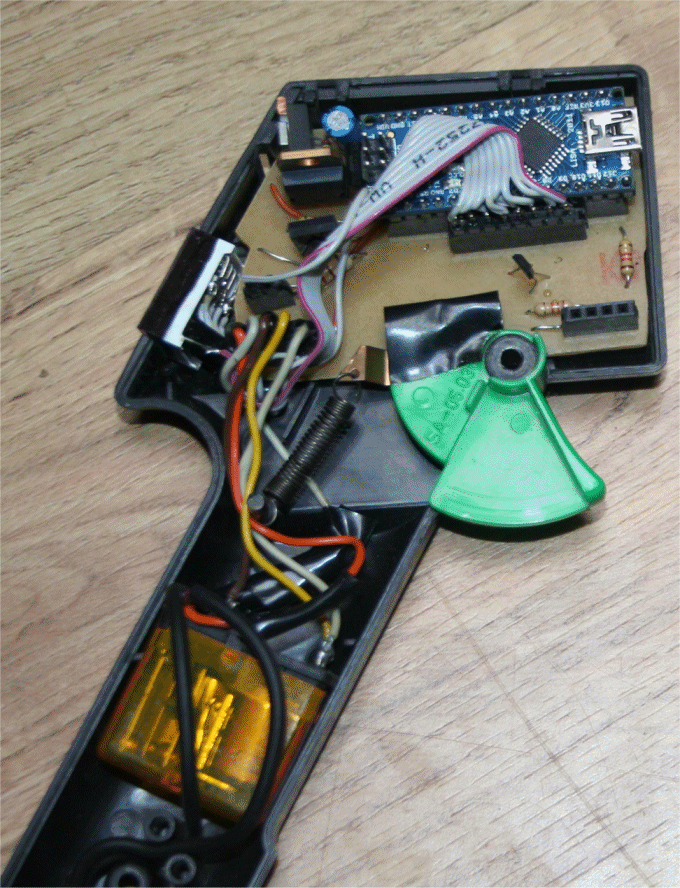
imagenes/scx_nano_peque.gif
