antoniolosada/SLOT/docs/Componentes/Componentes.gif

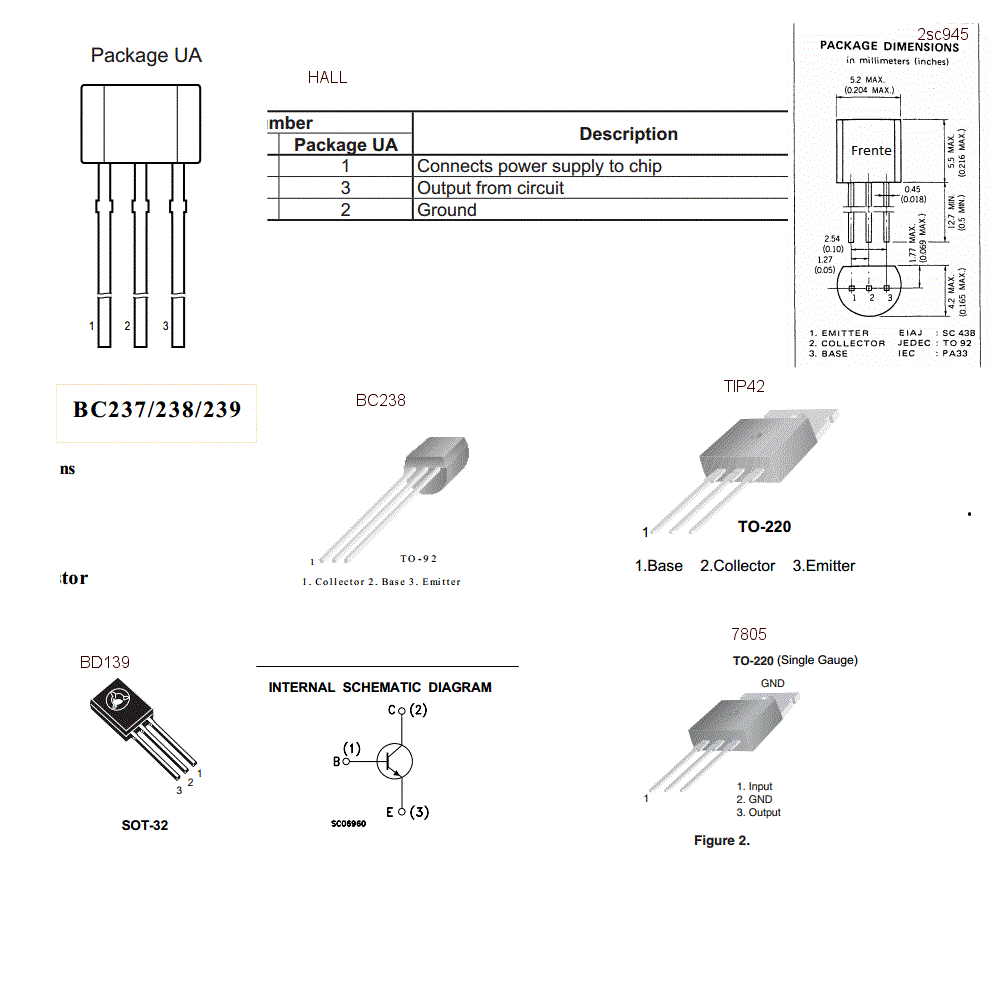
docs/Componentes/Componentes.gif
