antoniolosada/SLOT/docs/Componentes/Diagrama Display doble 1.jpg

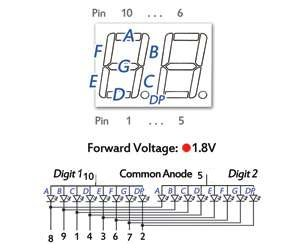
docs/Componentes/Diagrama Display doble 1.jpg
