antoniolosada/SLOT/imagenes/componentes_nano.gif

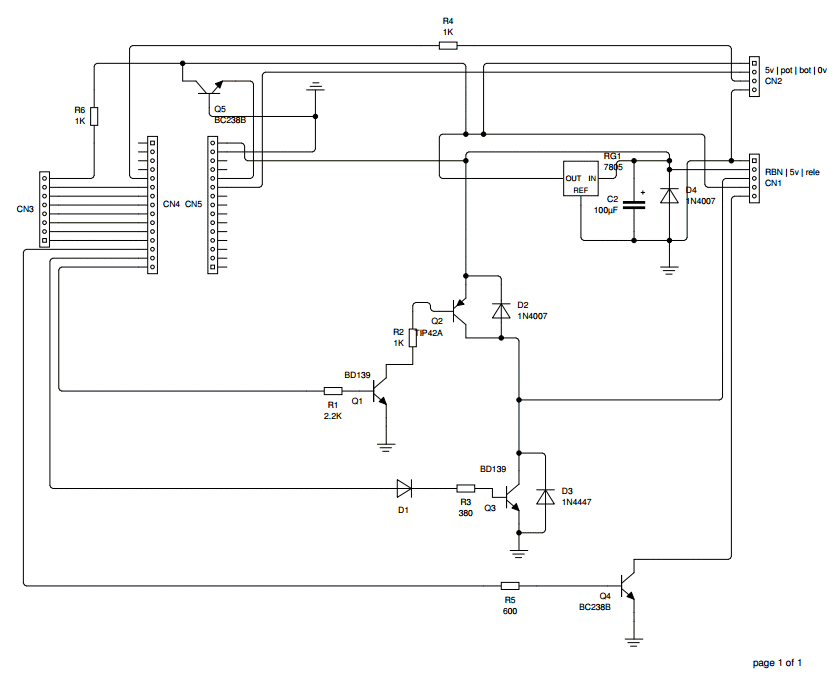
imagenes/componentes_nano.gif
