antoniolosada/SLOT/Modelos3D/gatillo2dedosimprimir.stl

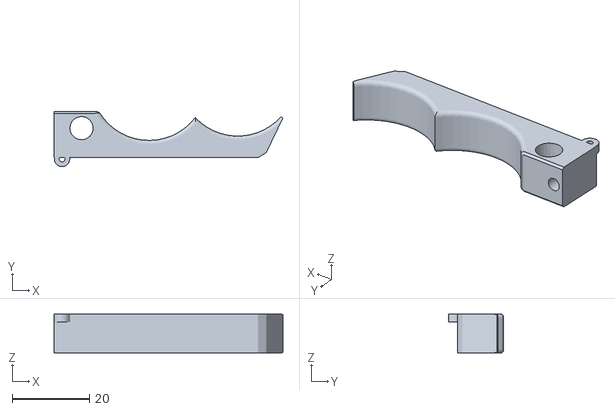
[picture p60: CAD file, 2018-04-20]
Modelos3D/gatillo2dedosimprimir.stl
59.2 x 14.3 x 10.0
