antoniolosada/SLOT/Modelos3D/caja DS.stl

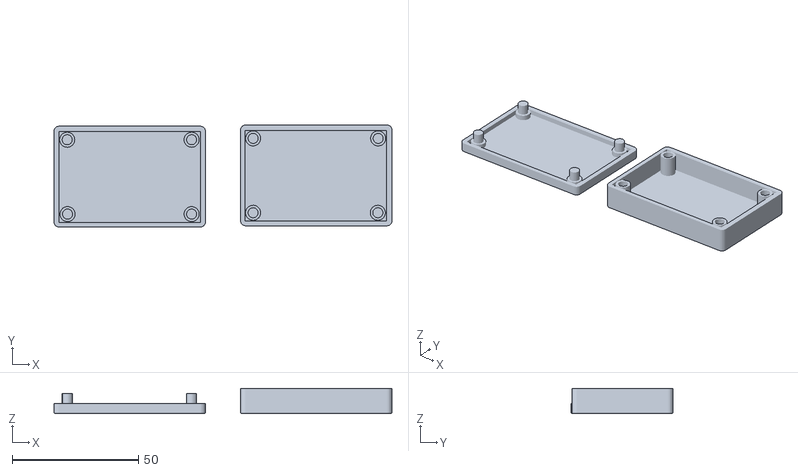
[picture p61: CAD file, 2018-04-20]
Modelos3D/caja DS.stl
133.9 x 40.5 x 10.0
