antoniolosada/SLOT/docs/mando.PDF

U1

X1

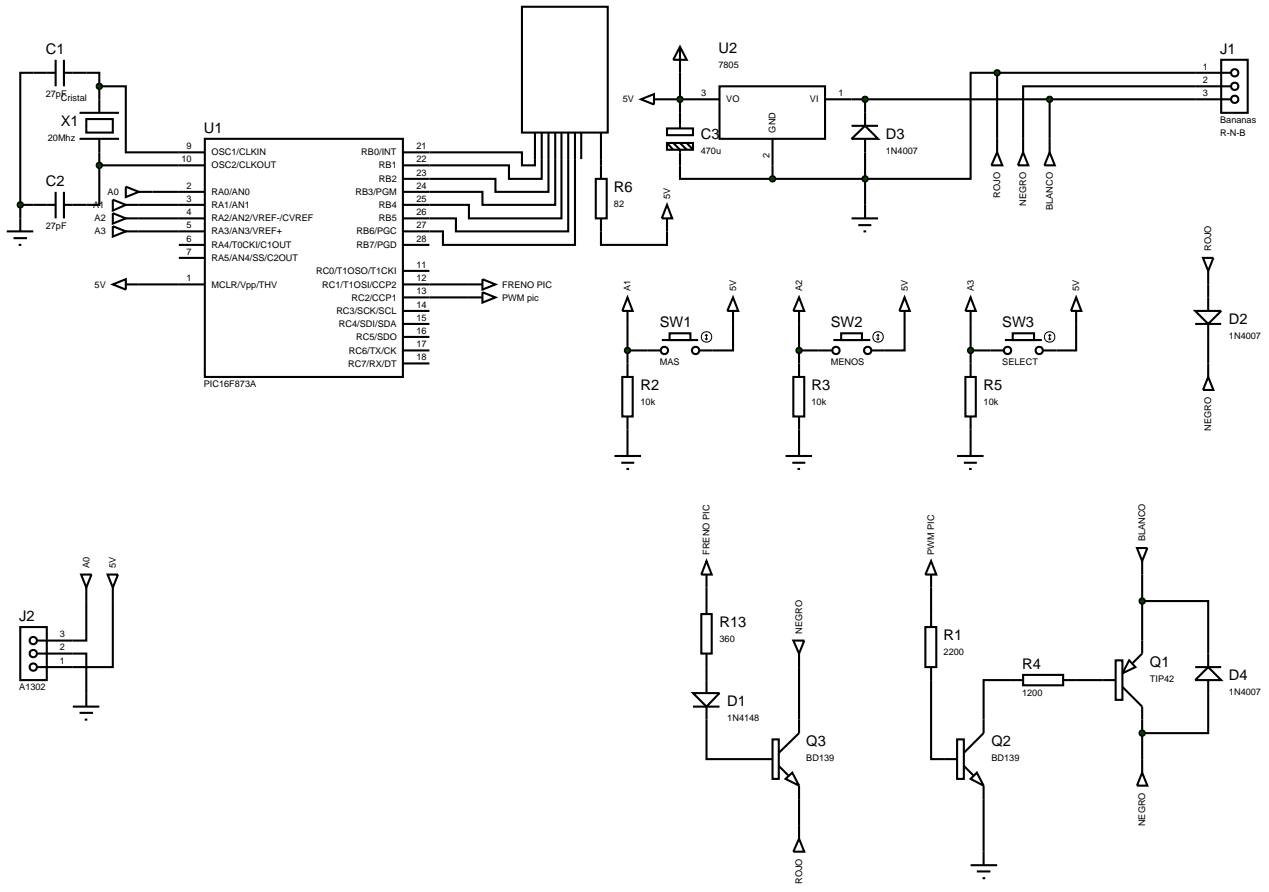
[picture p73: page 1]
