antoniolosada/SLOT/(list of files, drawings)

Other design files:
docs/atmega328_piso1y2_scx.pcb
docs/atmega328_piso1y2_scx_placa.pcb
docs/atmega328_piso2.pcb
docs/circuito_nano2.pcb
docs/circuito_nano3.pcb
docs/circuito_nano4.pcb
docs/circuito_nano5.pcb
docs/circuito_nano6.pcb
docs/circuito_nano.pcb
docs/espejo_piso2.pcb
docs/esquema.pcb
docs/esquema_atmega328.pcb
docs/esquema_atmega328_2pisos.pcb
docs/esquema_nano.pcb
docs/HERMES digital.pcb
docs/HERMES mando analógico v1.1.pcb
docs/HERMES mando analógico v1.2.pcb
docs/HERMES mando analógico v1.3.pcb
docs/HERMES mando analógico v1.4.pcb
docs/HERMES v1.pcb
docs/Hermes_1.3_impresion.pcb
docs/hermes_1_3_2.pcb
docs/mando_carcasa_parma.pcb
docs/Placa conector v2.pcb
docs/Plantilla conector.pcb
Perfil mando con agujeros evo2.pcb
perfil mando entero.pcb
